R-Mutura/HDMI-TO-MIPI-MAIN/assets/PCB Design.jpg

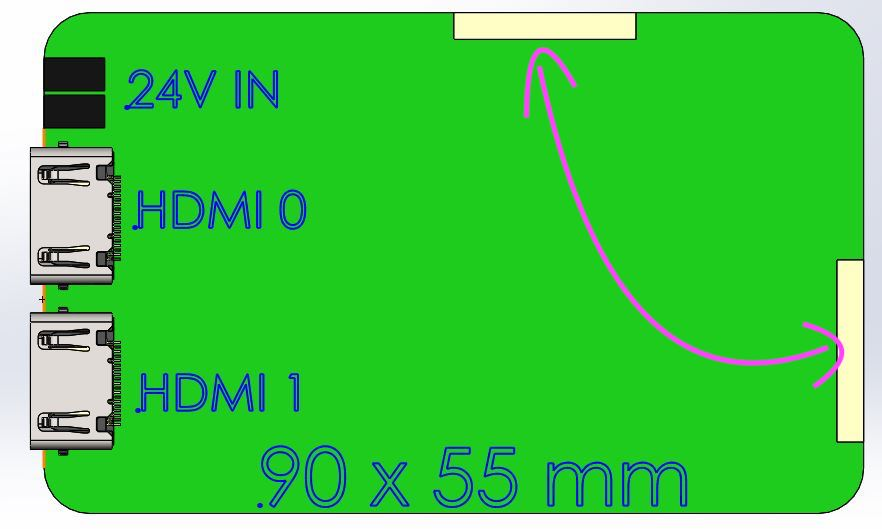
assets/PCB Design.jpg
