R-Mutura/HDMI-TO-MIPI-MAIN/assets/image (2).png

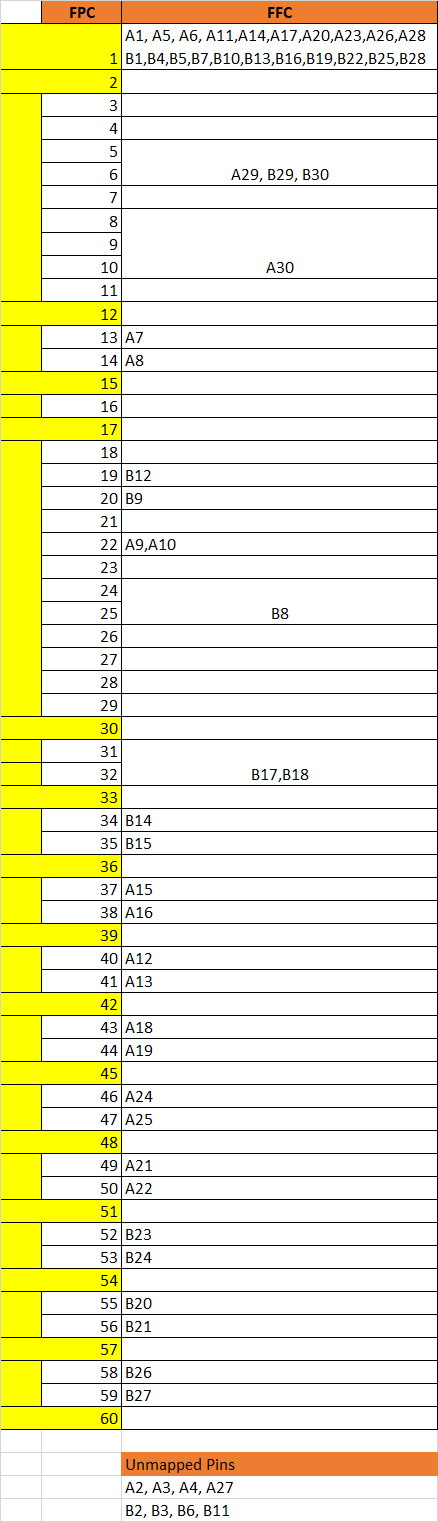
assets/image (2).png
