R-Mutura/HDMI-TO-MIPI-MAIN/assets/TC358870_1.jpeg

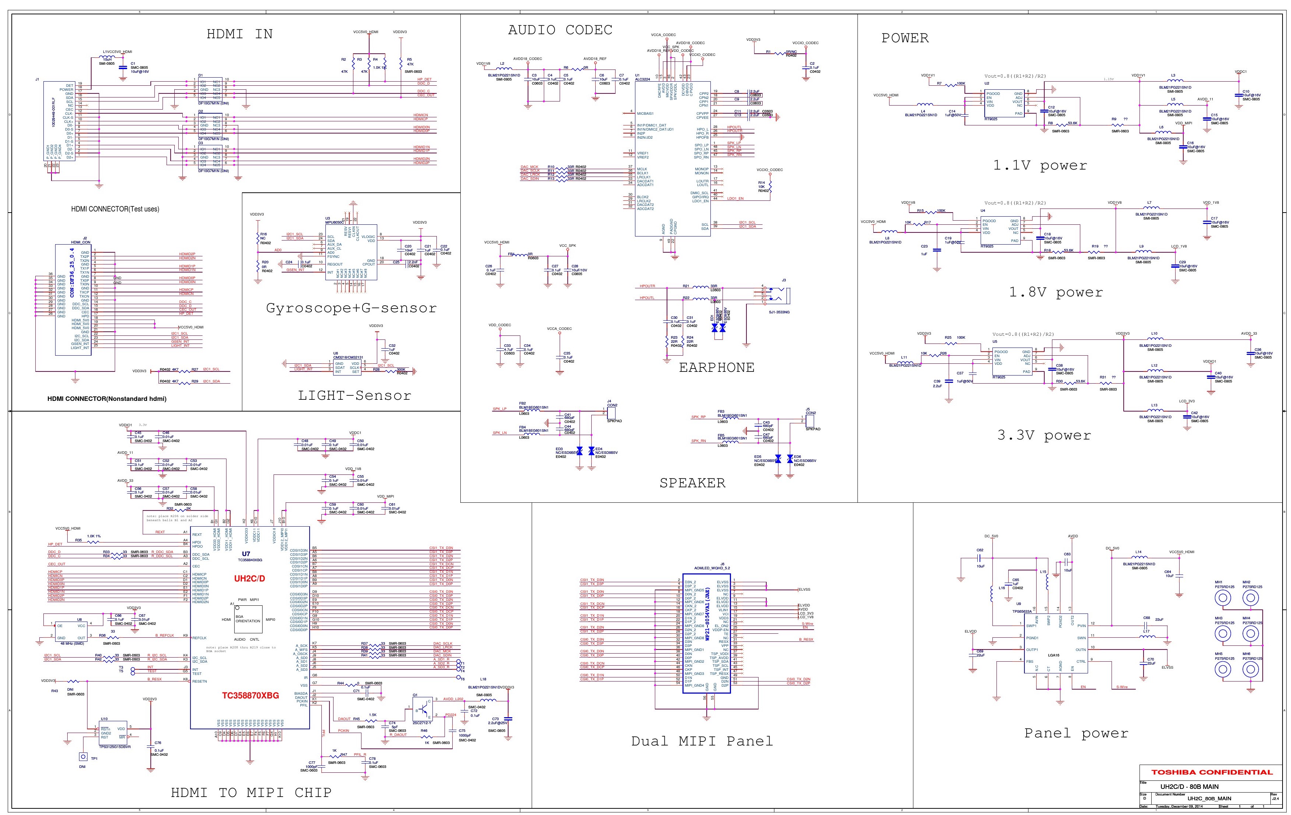
assets/TC358870_1.jpeg
