R-Mutura/HDMI-TO-MIPI-MAIN/img/hdmi_to_mipi-dsi_converter_1.png

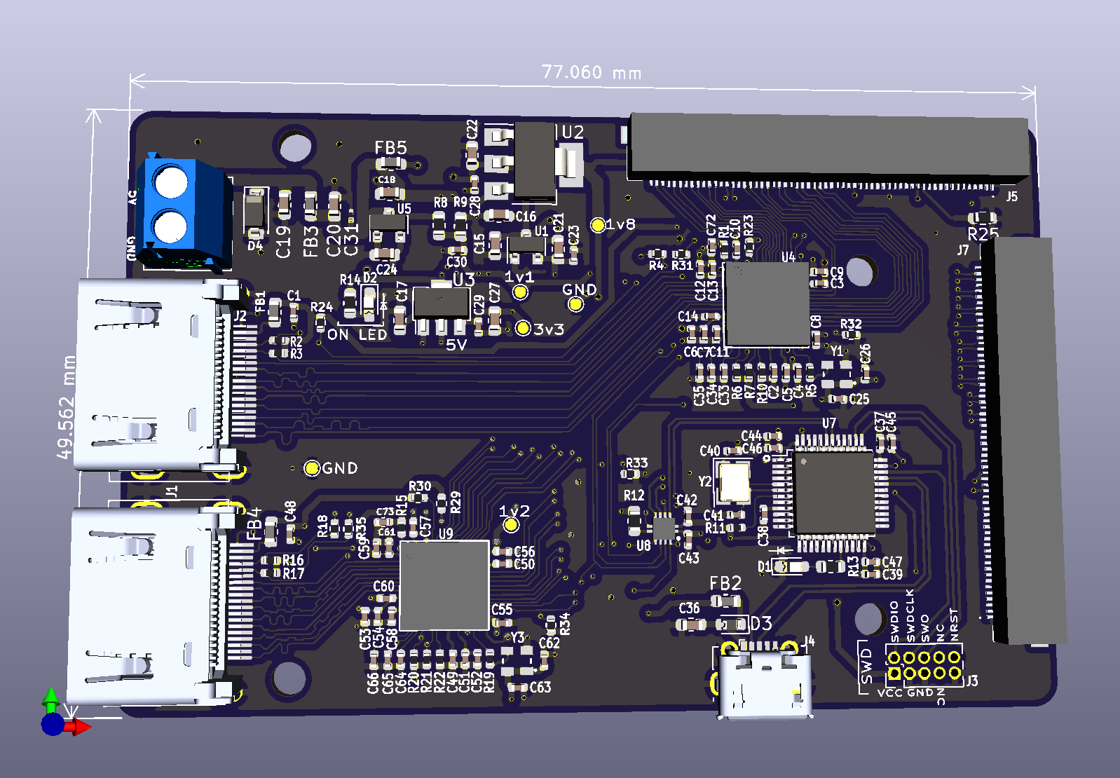
img/hdmi_to_mipi-dsi_converter_1.png
