R-Mutura/HDMI-TO-MIPI-MAIN/bom/hdmi_to_mipi-dsi_converter version 2.xlsx

REFERNCE | VALUE | FOOTPRINT | DESCRIPTION | DESCRIPTION | MFR | MPN | SUPPLIER | QUANTITY
C1, C3, C5, C7, C9, C11, C13, C14, C48, C50, C52, C54, C56, C58, C60, C61 | 10n | Capacitor_SMD:C_0402_1005Metric | 402 |  | YAGEO | CC0402KRX5R8BB103 | LCSC | 16
C16, C22 | 10uF | Capacitor_SMD:C_0603_1608Metric | 603 |  | YAGEO | CC0603KRX5R6BB106 | LCSC | 2
C17, C20 | 1uF | Capacitor_SMD:C_0603_1608Metric | 603 |  | YAGEO | CC0603KRX5R8BB105 | LCSC | 2
C2, C4, C6, C8, C10, C12, C23, C25, C29, C30, C33-C35, C37-C39, C42, C43, C49, C51, C53, C55, C57, C59, C62, C64-C66 | 0.1u | Capacitor_SMD:C_0402_1005Metric | ... |  | YAGEO | CC0402KRX7R7BB104 | LCSC | 28
C26, C63 | 0.01u | Capacitor_SMD:C_0402_1005Metric |  |  | YAGEO | CC0402KRX5R8BB103 | LCSC | 2
C27 | 1u | Capacitor_SMD:C_0603_1608Metric |  |  | YAGEO | CC0603KRX5R8BB105 | LCSC | 1
C28 | 0.1uF | Capacitor_SMD:C_0402_1005Metric |  |  | YAGEO | CC0402KRX7R7BB104 | LCSC | 1
C31 | 10pF | Capacitor_SMD:C_0603_1608Metric |  |  |  | GJM1555C1H100JB01D | DigiKey | 1
C15, C18, C19, C21, C24, C36 | 10u | Capacitor_SMD:C_0603_1608Metric |  |  | YAGEO | CC0603KRX5R6BB106 | LCSC | 6
> C40, C41 | 18p | Capacitor_SMD:C_0402_1005Metric | NPO 0402 |  | YAGEO | CC0402JRNPO9BN180 | LCSC | 2
> C44, C45 | 10u | Capacitor_SMD:C_0402_1005Metric |  |  | YAGEO | CC0402MRX5R5BB106 | LCSC | 2
> C46, C47 | 4.7u | Capacitor_SMD:C_0402_1005Metric |  |  | YAGEO | CC0402KRX5R6BB475 | LCSC | 2
> C72, C73 | 10nF | Capacitor_SMD:C_0402_1005Metric |  |  | YAGEO (https://lcsc.com/product-detail/Multilayer-Ceramic-Capacitors-MLCC-SMD-SMT_YAGEO-CC0402KRX7R9BB103_C60133.html) | CC0402KRX7R9BB103 (https://lcsc.com/product-detail/Multilayer-Ceramic-Capacitors-MLCC-SMD-SMT_YAGEO-CC0402KRX7R9BB103_C60133.html) | LCSC | 2
> D1, D2 | LED_Small | LED_SMD:LED_0603_1608Metric_Castellated |  |  | LITEON | LTST-C191KRKT (https://www.digikey.com/en/products/detail/lite-on-inc/LTST-C191KRKT/386837) | DigiKey | 2
D3 | CDBURT0530LL-HF | Diode_SMD:D_0603_1608Metric |  | 500mA | Comchip Technology | CDBURT0530LL-HF | DigiKey | 1
D4 | FSV360FP | Diode_SMD:D_SOD-123 |  |  | onsemi | FSV360FP | DigiKey | 1
> FB1, FB4 | FBMJ1608HS280NTR | Inductor_SMD:L_0603_1608Metric |  |  | Taiyo Yuden | FBMJ1608HS280NTR | DigiKey | 2
FB2 | FBMJ1608HS280NTR | Inductor_SMD:L_0603_1608Metric |  |  | Taiyo Yuden | FBMJ1608HS280NTR | DigiKey | 1
FB3, FB5 | FBMJ1608HS280NTR | Inductor_SMD:L_0603_1608Metric |  |  | Taiyo Yuden | FBMJ1608HS280NTR | DigiKey | 2
J1, J2 | HDMI-019S | HDMI:HDMI-019S |  |  | SOFNG | HDMI-019S | LCSC | 2
J3 | Conn_02x05_Odd_Even | Connector_PinHeader_1.27mm:PinHeader_2x05_P1.27mm_Vertical |  |  | Amphenol ICC (FCI) | 20021111-00010T1LF | DigiKey | 1
J4 | USB_B_Micro | Connector_USB:USB_Micro-B_Molex-105017-0001 |  |  | MOLEX | 1050170001 | LCSC | 1
> J5, J7 | XF2M60151AH | 60_PIN_FPC:XF2M60151AH |  |  | Omron Electronics | XF2M-6015-1AH | LCSC | 2
J6 | Conn_01x02 | TerminalBlock_4Ucon:TerminalBlock_4Ucon_1x02_P3.50mm_Horizontal |  |  | Cixi Kefa Elec | KF350-3.5-2P | LCSC | 1
> R1, R15 | 2k | Resistor_SMD:R_0402_1005Metric |  |  | YAGEO | RC0402JR-072KL | LCSC | 2
> R2, R3, R16, R17 | 47k | Resistor_SMD:R_0402_1005Metric |  |  | YAGEO | RC0402FR-0747KL | DigiKey | 4
> R4, R18, R31, R35 | 33 Ohm | Resistor_SMD:R_0402_1005Metric |  |  | YAGEO | RC0402JR-0733RL | LCSC | 4
> R5, R19 | 33R | Resistor_SMD:R_0402_1005Metric |  |  | YAGEO | RC0402FR-0733RL | LCSC | 2
R8 | 4k | Resistor_SMD:R_0603_1608Metric |  |  | YAGEO | AC0603FR-074K02L | LCSC | 1
R9 | 2k | Resistor_SMD:R_0603_1608Metric |  |  | YAGEO | RC0603FR-072KL | LCSC | 1
R6, R7, R10, R11, R20-R22 | 10k | Resistor_SMD:R_0402_1005Metric |  |  | YAGEO | SR0402FR-0710KL | LCSC | 7
R12 | 47k | Resistor_SMD:R_0603_1608Metric |  |  | YAGEO | RC0603FR-0747KL | LCSC | 1
R13, R14 | 1k | Resistor_SMD:R_0603_1608Metric |  |  | YAGEO | AC0603FR-071KL | LCSC | 2
R23, R24, R29, R30 | 2.2K | Resistor_SMD:R_0402_1005Metric |  |  | YAGEO | RC0402JR-072K2L | DigiKey | 4
R25 | 61.9K | Resistor_SMD:R_0603_1608Metric |  |  | Stackpole Electronics Inc | RMCF0603FT61K9 | DigiKey | 1
R32, R34 | 10K | Resistor_SMD:R_0402_1005Metric |  |  | YAGEO | SR0402FR-0710KL | DigiKey | 2
R33 | 47K | Resistor_SMD:R_0402_1005Metric |  |  | YAGEO | RC0402FR-0747KL | DigiKey | 1
U1 | MCP1700-1202E_SOT23 | Package_TO_SOT_SMD:SOT-23 |  |  | Microchip Tech | MCP1700-1202E_SOT23 | LCSC | 1
U2 | AX1007E18A | Package_TO_SOT_SMD:SOT-223-3_TabPin2 | 1A |  | Axelite Tech | AX1007E18A | LCSC | 1
U3 | ME6211A33PG-N | Package_TO_SOT_SMD:SOT-89-3 | 500mA |  | MICRON | ME6211A33PG-N | LCSC | 1
U4, U9 | TC358870XBG_NOK_ | TC358870XBG:VFBGA-80_7x7mm_Pitch0.65mm |  |  | Toshiba | TC358870XBG(NOK) | MOUSER | 2
U5 | MCP1700-3302E_SOT23 | Package_TO_SOT_SMD:SOT-23 |  |  | Microchip Tech | MCP1700T-3302E/TT | LCSC | 1
U7 | STM32F103C8Tx | Package_QFP:LQFP-48_7x7mm_P0.5mm |  |  | STMicroelectronics | STM32F103C8Tx | LCSC | 1
U8 | FXMA2104UMX | Barrel - Audio Connectors:QFN40P180X180X55-12N |  |  | ON Semiconductor | FXMA2104UMX | LCSC | 1
Y1, Y3 | CRYSTAL_48MHZ | Barrel - Audio Connectors:DSC6101JI2A-048.0000 |  |  | Microchip Technology | DSC6101JI2A-048.0000 | DIGIKEY | 2
Y2 | 8MHz | Crystal:Crystal_SMD_3225-4Pin_3.2x2.5mm |  |  | XTY | 7325-0800A2010-00 | LCSC | 1
