R-Mutura/HDMI-TO-MIPI-MAIN/sch_pdf/schematic.pdf

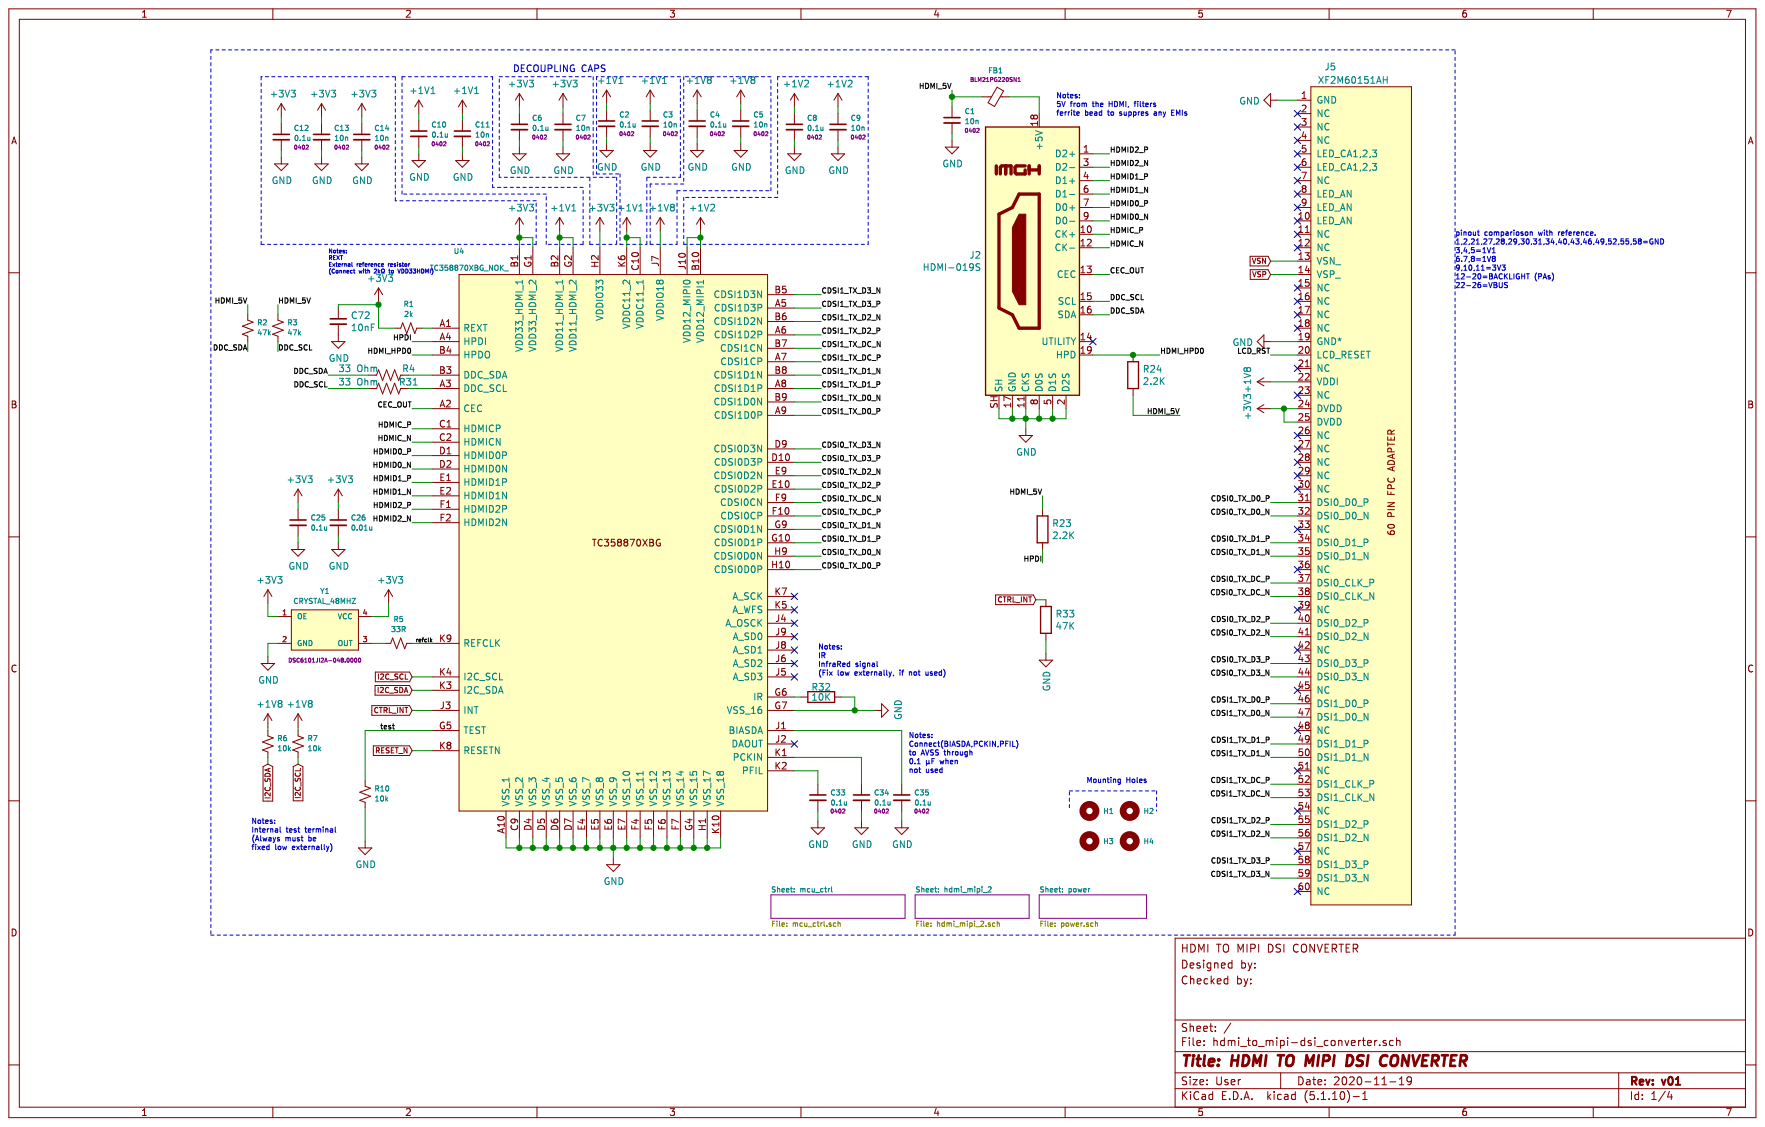
[picture p10: page 1]

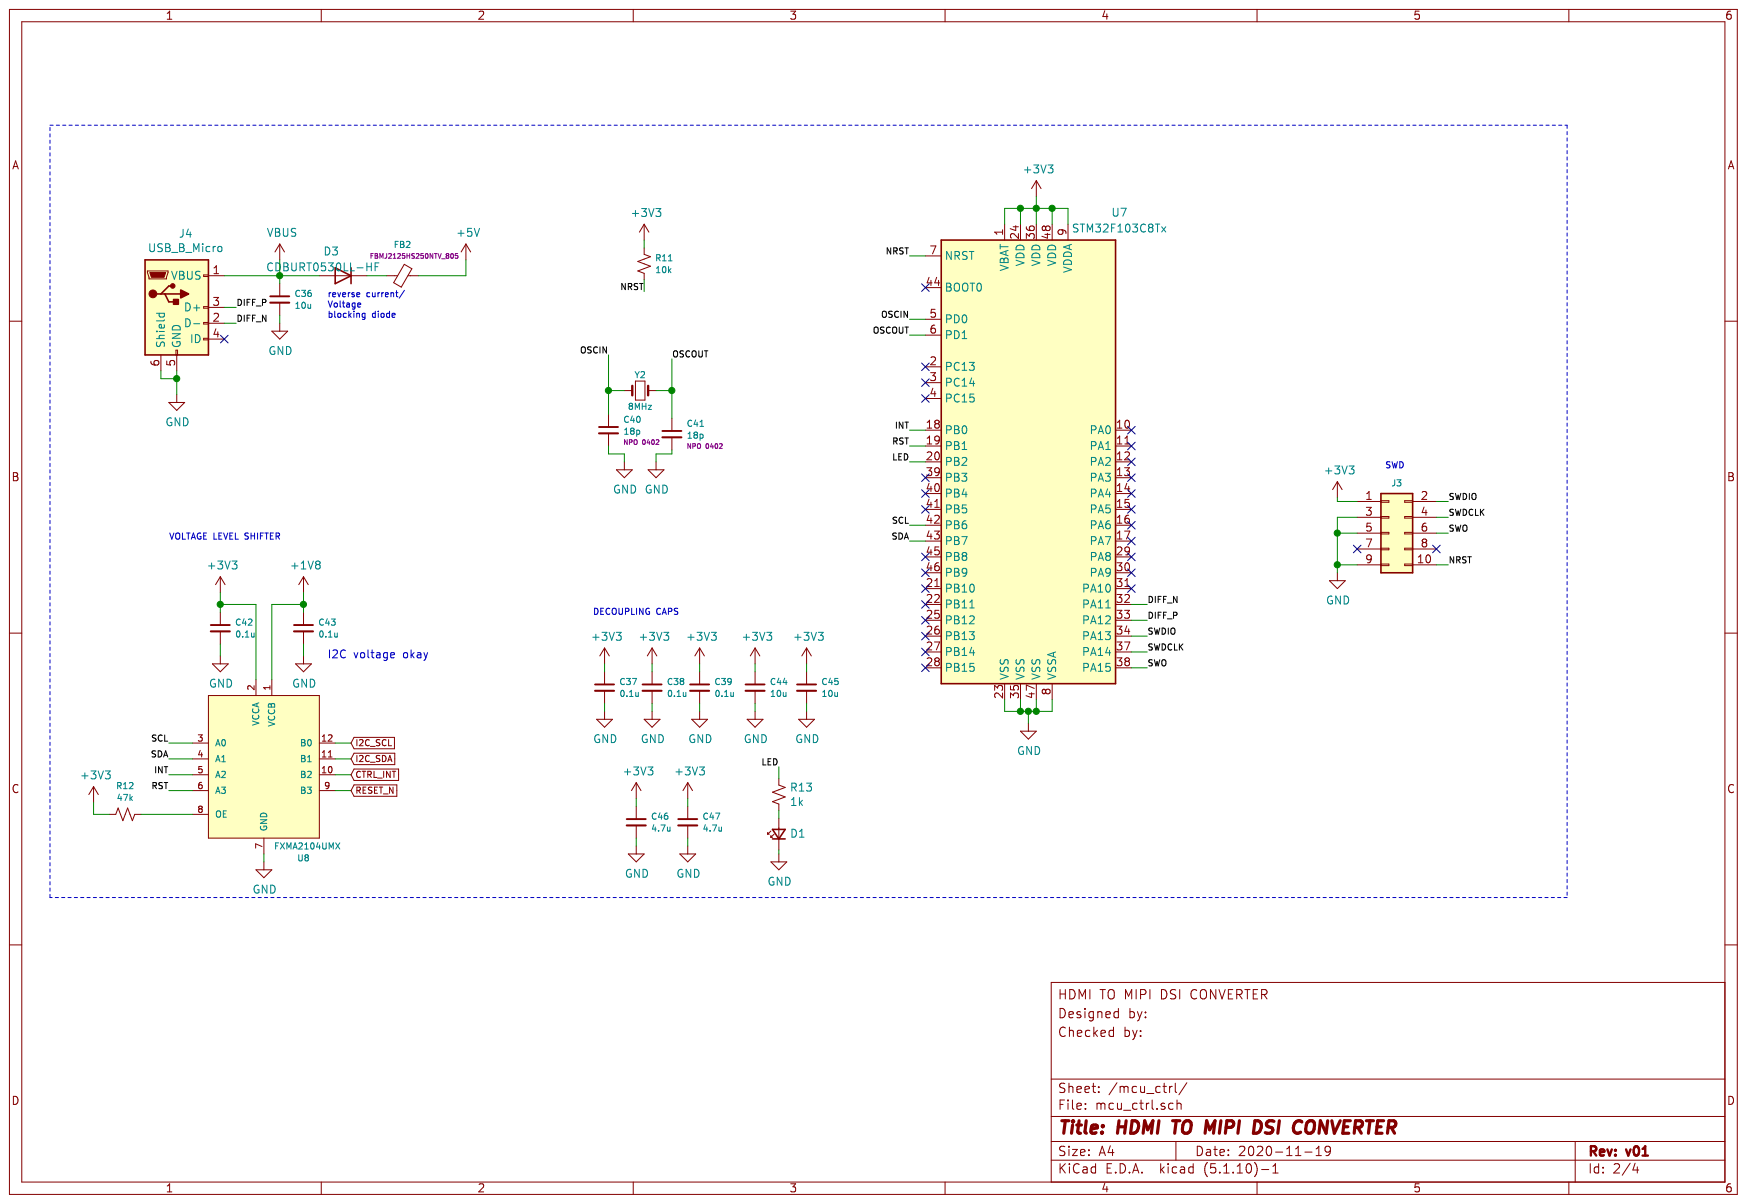
[picture p11: page 2]

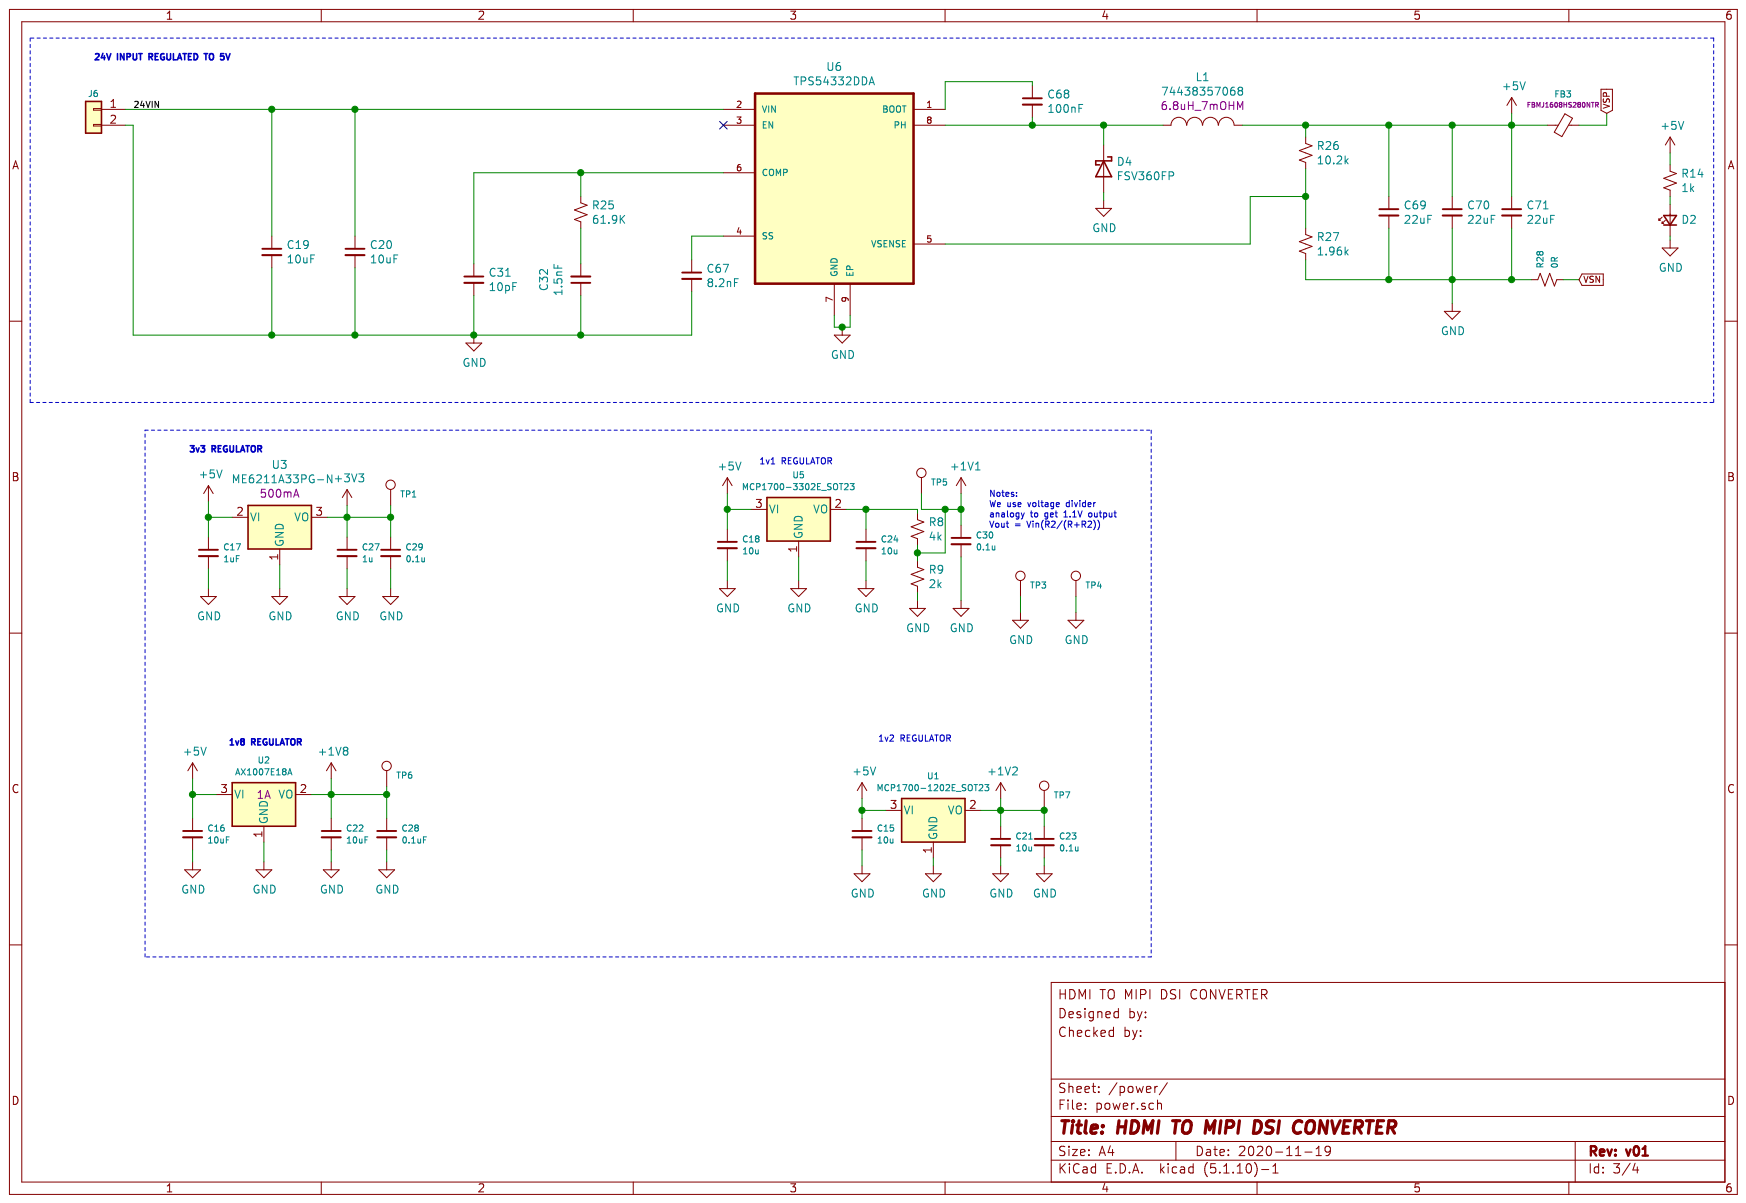
[picture p12: page 3]

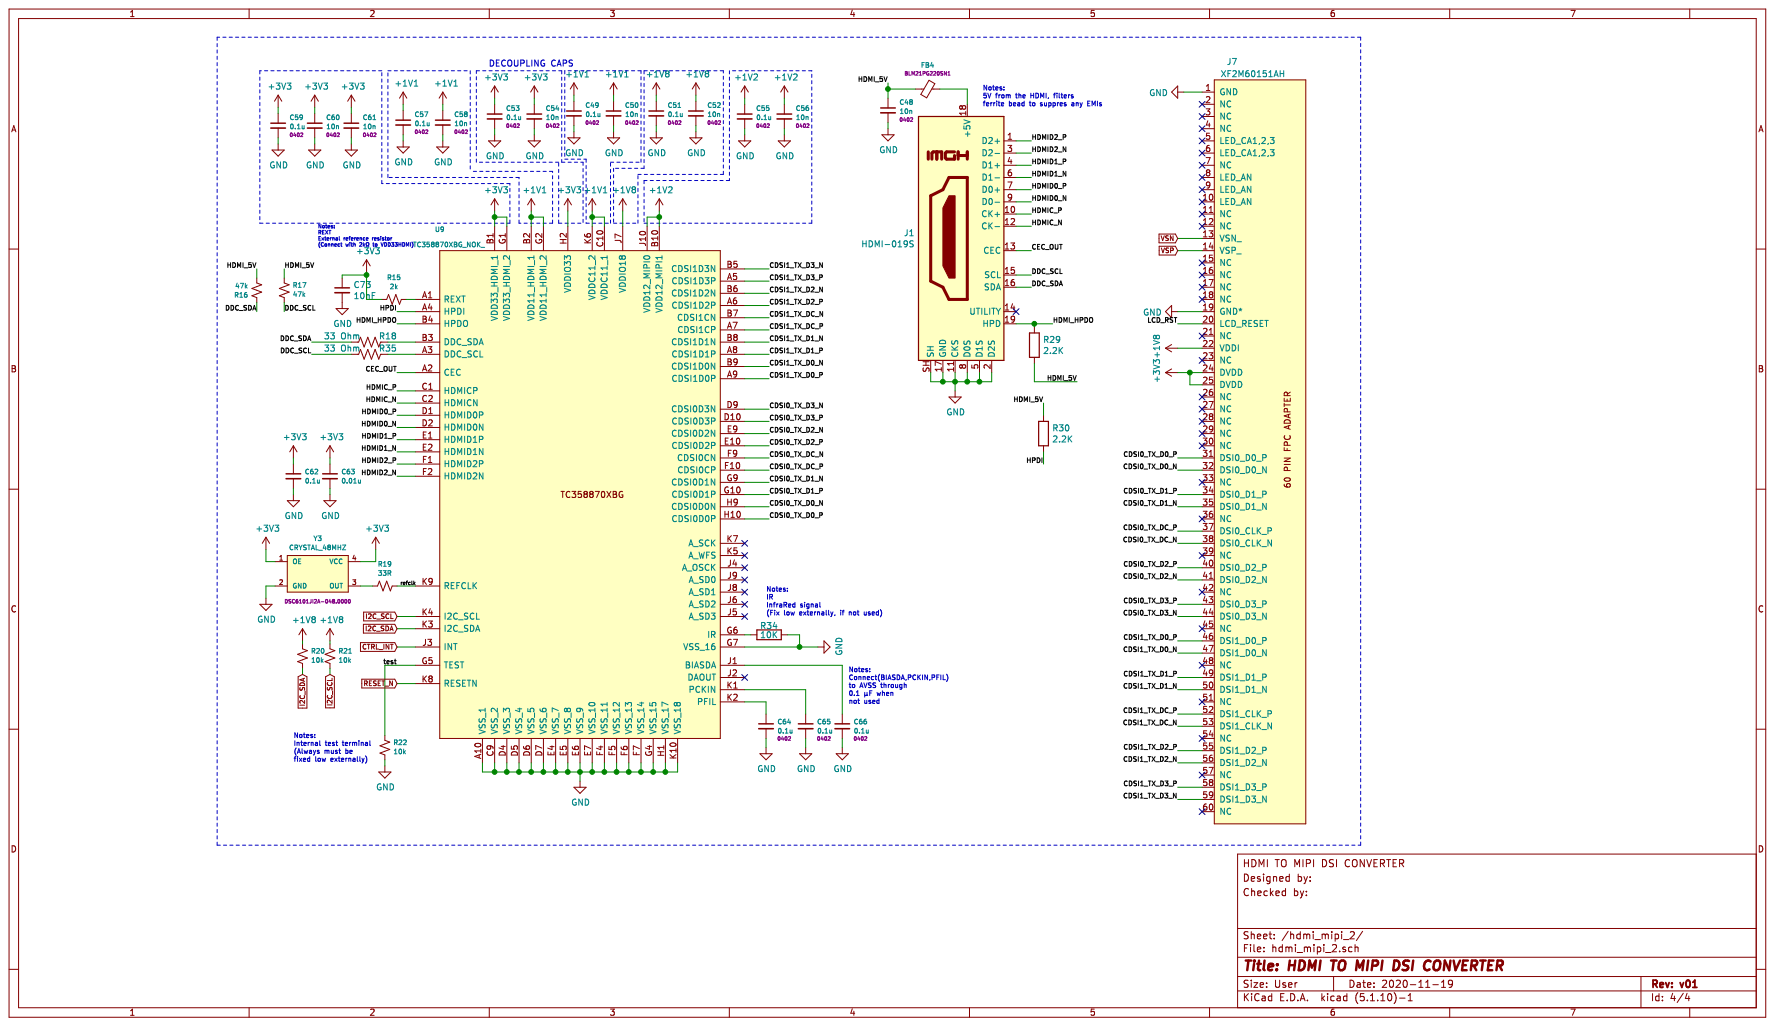
[picture p13: page 4]
