R-Mutura/HDMI-TO-MIPI-MAIN/src_files/hdmi_to_mipi-dsi_converter.kicad_pcb

## KiCad design src_files/hdmi_to_mipi-dsi_converter.kicad_pcb (2021-12-23)

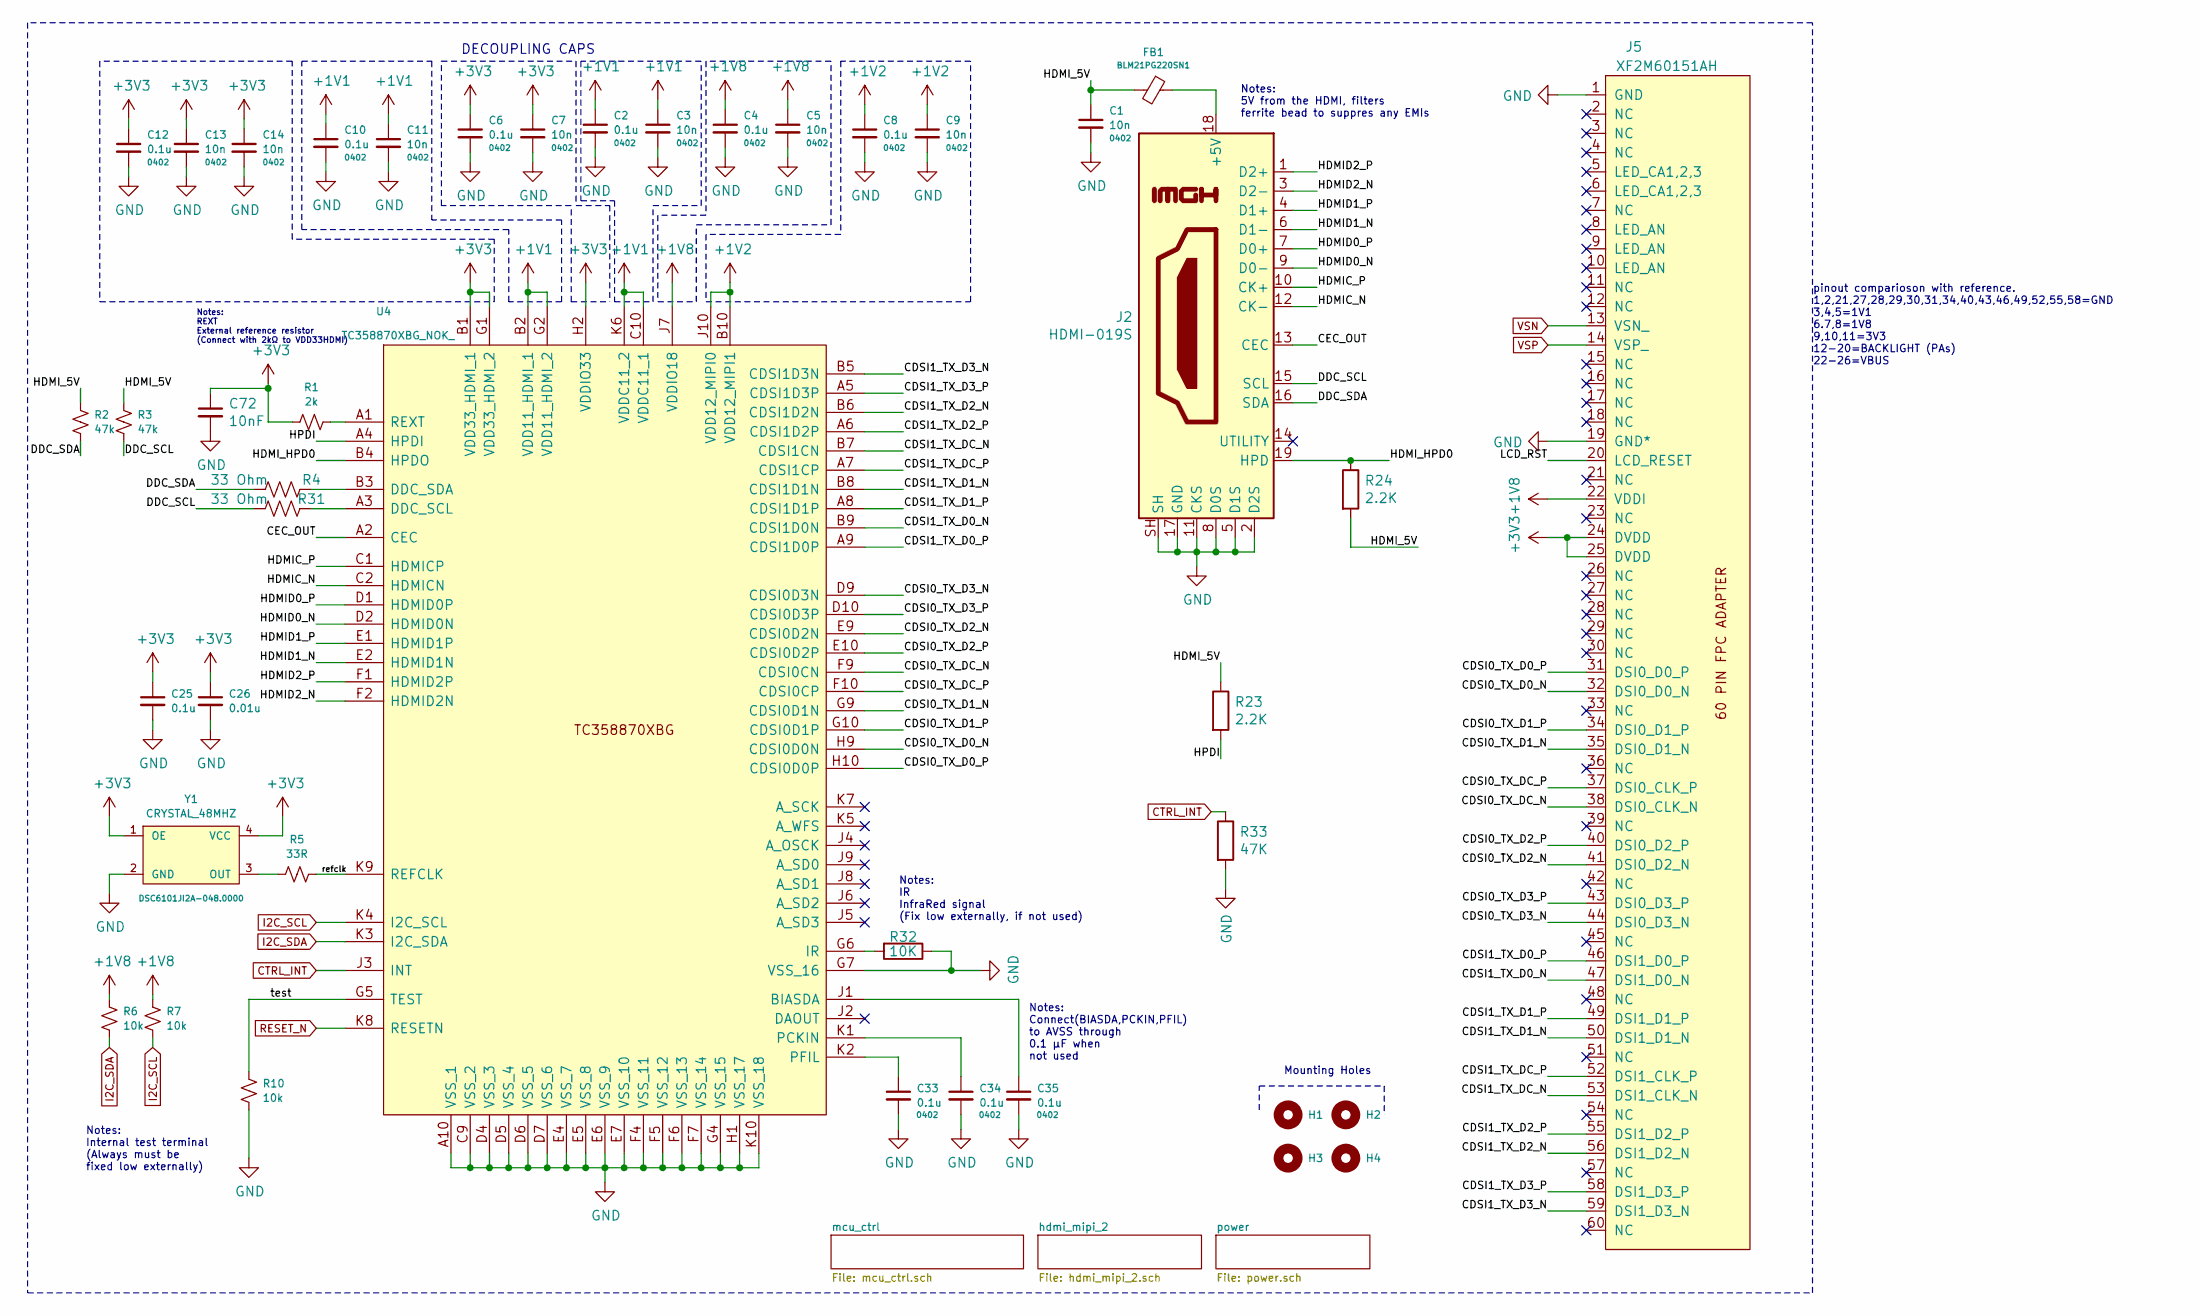
[picture p14: schematic hdmi_to_mipi-dsi_converter.sch, HDMI TO MIPI DSI CONVERTER]

Parts:
C1, C3, C5, C7, C9, C11, C13, C14: 10n; C_0402_1005Metric
C2, C4, C6, C8, C10, C12, C25, C33, C34, C35: 0.1u; C_0402_1005Metric
C26: 0.01u; C_0402_1005Metric
C72: 10nF; C_0402_1005Metric
FB1: Ferrite_Bead_Small; L_0603_1608Metric; MPN BLM21PG220SN1
H1, H2, H3, H4: MountingHole; MountingHole_2.7mm_M2.5
J2: HDMI-019S; MPN HDMI-019S
J5: XF2M60151AH
R1: 2k; R_0402_1005Metric
R2, R3: 47k; R_0402_1005Metric
R4, R31: 33 Ohm; R_0402_1005Metric
R5: 33R; R_0402_1005Metric
R6, R7, R10: 10k; R_0402_1005Metric
R23, R24: 2.2K; R_0402_1005Metric
R32: 10K; R_0402_1005Metric
R33: 47K; R_0402_1005Metric
U4: TC358870XBG_NOK_; VFBGA-80_7x7mm_Pitch0.65mm; MPN TC358870XBG(NOK)
Y1: CRYSTAL_48MHZ; DSC6101JI2A-048.0000; MPN DSC6101JI2A-048.0000

Connections:
+1V1: C2.1, C3.1, C10.1, C11.1, U4.B2 (VDD11_HDMI_1), U4.C10 (VDDC11_1), U4.G2 (VDD11_HDMI_2), U4.K6 (VDDC11_2); also elsewhere on the board
+1V2: C8.1, C9.1, U4.B10 (VDD12_MIPI1), U4.J10 (VDD12_MIPI0); also elsewhere on the board
+1V8: C4.1, C5.1, J5.22 (VDDI), R6.2, R7.2, U4.J7 (VDDIO18); also elsewhere on the board
+3V3: C6.1, C7.1, C12.1, C13.1, C14.1, C25.1, C26.1, C72.1, J5.24 (DVDD), J5.25 (DVDD), R1.2, U4.B1 (VDD33_HDMI_1), U4.G1 (VDD33_HDMI_2), U4.H2 (VDDIO33), Y1.1 (OE), Y1.4 (VCC); also elsewhere on the board
/CDSI0_TX_D0_N: J5.32 (DSI0_D0_N), U4.H9 (CDSI0D0N)
/CDSI0_TX_D0_P: J5.31 (DSI0_D0_P), U4.H10 (CDSI0D0P)
/CDSI0_TX_D1_N: J5.35 (DSI0_D1_N), U4.G9 (CDSI0D1N)
/CDSI0_TX_D1_P: J5.34 (DSI0_D1_P), U4.G10 (CDSI0D1P)
/CDSI0_TX_D2_N: J5.41 (DSI0_D2_N), U4.E9 (CDSI0D2N)
/CDSI0_TX_D2_P: J5.40 (DSI0_D2_P), U4.E10 (CDSI0D2P)
/CDSI0_TX_D3_N: J5.44 (DSI0_D3_N), U4.D9 (CDSI0D3N)
/CDSI0_TX_D3_P: J5.43 (DSI0_D3_P), U4.D10 (CDSI0D3P)
/CDSI0_TX_DC_N: J5.38 (DSI0_CLK_N), U4.F9 (CDSI0CN)
/CDSI0_TX_DC_P: J5.37 (DSI0_CLK_P), U4.F10 (CDSI0CP)
/CDSI1_TX_D0_N: J5.47 (DSI1_D0_N), U4.B9 (CDSI1D0N)
/CDSI1_TX_D0_P: J5.46 (DSI1_D0_P), U4.A9 (CDSI1D0P)
/CDSI1_TX_D1_N: J5.50 (DSI1_D1_N), U4.B8 (CDSI1D1N)
/CDSI1_TX_D1_P: J5.49 (DSI1_D1_P), U4.A8 (CDSI1D1P)
/CDSI1_TX_D2_N: J5.56 (DSI1_D2_N), U4.B6 (CDSI1D2N)
/CDSI1_TX_D2_P: J5.55 (DSI1_D2_P), U4.A6 (CDSI1D2P)
/CDSI1_TX_D3_N: J5.59 (DSI1_D3_N), U4.B5 (CDSI1D3N)
/CDSI1_TX_D3_P: J5.58 (DSI1_D3_P), U4.A5 (CDSI1D3P)
/CDSI1_TX_DC_N: J5.53 (DSI1_CLK_N), U4.B7 (CDSI1CN)
/CDSI1_TX_DC_P: J5.52 (DSI1_CLK_P), U4.A7 (CDSI1CP)
/CEC_OUT: J2.13 (CEC), U4.A2 (CEC)
/DDC_SCL: J2.15 (SCL), R3.1, R31.2
/DDC_SDA: J2.16 (SDA), R2.1, R4.2
/HDMIC_N: J2.12 (CK-), U4.C2 (HDMICN)
/HDMIC_P: J2.10 (CK+), U4.C1 (HDMICP)
/HDMID0_N: J2.9 (D0-), U4.D2 (HDMID0N)
/HDMID0_P: J2.7 (D0+), U4.D1 (HDMID0P)
/HDMID1_N: J2.6 (D1-), U4.E2 (HDMID1N)
/HDMID1_P: J2.4 (D1+), U4.E1 (HDMID1P)
/HDMID2_N: J2.3 (D2-), U4.F2 (HDMID2N)
/HDMID2_P: J2.1 (D2+), U4.F1 (HDMID2P)
/HDMI_5V: C1.1, FB1.2, R2.2, R3.2, R23.1, R24.2
/HDMI_HPD0: J2.19 (HPD), R24.1, U4.B4 (HPDO)
/HPDI: R23.2, U4.A4 (HPDI)
/refclk: R5.1, U4.K9 (REFCLK)
/test: R10.2, U4.G5 (TEST)
CTRL_INT: R33.1, U4.J3 (INT); also elsewhere on the board
GND: C1.2, C2.2, C3.2, C4.2, C5.2, C6.2, C7.2, C8.2, C9.2, C10.2, C11.2, C12.2, C13.2, C14.2, C25.2, C26.2, C33.2, C34.2, C35.2, C72.2, J2.2 (D2S), J2.5 (D1S), J2.8 (D0S), J2.11 (CKS), J2.17 (GND), J2.SH, J5.1 (GND), J5.19 (GND*), R10.1, R32.1, R33.2, U4.A10 (VSS_1), U4.C9 (VSS_2), U4.D4 (VSS_3), U4.D5 (VSS_4), U4.D6 (VSS_5), U4.D7 (VSS_6), U4.E4 (VSS_7), U4.E5 (VSS_8), U4.E6 (VSS_9), U4.E7 (VSS_10), U4.F4 (VSS_11), U4.F5 (VSS_12), U4.F6 (VSS_13), U4.F7 (VSS_14), U4.G4 (VSS_15), U4.G7 (VSS_16), U4.H1 (VSS_17), U4.K10 (VSS_18), Y1.2 (GND); also elsewhere on the board
I2C_SCL: R7.1, U4.K4 (I2C_SCL); also elsewhere on the board
I2C_SDA: R6.1, U4.K3 (I2C_SDA); also elsewhere on the board
unnamed: C33.1, U4.K2 (PFIL)
unnamed: C34.1, U4.K1 (PCKIN)
unnamed: C35.1, U4.J1 (BIASDA)
unnamed: FB1.1, J2.18 (+5V)
unnamed: R1.1, U4.A1 (REXT)
unnamed: R4.1, U4.B3 (DDC_SDA)
unnamed: R5.2, Y1.3 (OUT)
unnamed: R31.1, U4.A3 (DDC_SCL)
unnamed: R32.2, U4.G6 (IR)
RESET_N: U4.K8 (RESETN); also elsewhere on the board
VSN: J5.13 (VSN_); also elsewhere on the board
VSP: J5.14 (VSP_); also elsewhere on the board

Notes on the sheet:
DECOUPLING CAPS
Notes: Internal test terminal (Always must be fixed low externally)
Notes: IR InfraRed signal (Fix low externally, if not used)
Notes: Connect(BIASDA,PCKIN,PFIL) to AVSS through 0.1 μF when not used
Notes: REXT External reference resistor (Connect with 2kΩ to VDD33HDMI)
Notes: 5V from the HDMI, filters ferrite bead to suppres any EMIs
Mounting Holes
pinout comparioson with reference. 1,2,21,27,28,29,30,31,34,40,43,46,49,52,55,58=GND 3,4,5=1V1 6.7,8=1V8 9,10,11=3V3 12-20=BACKLIGHT (PAs) 22-26=VBUS

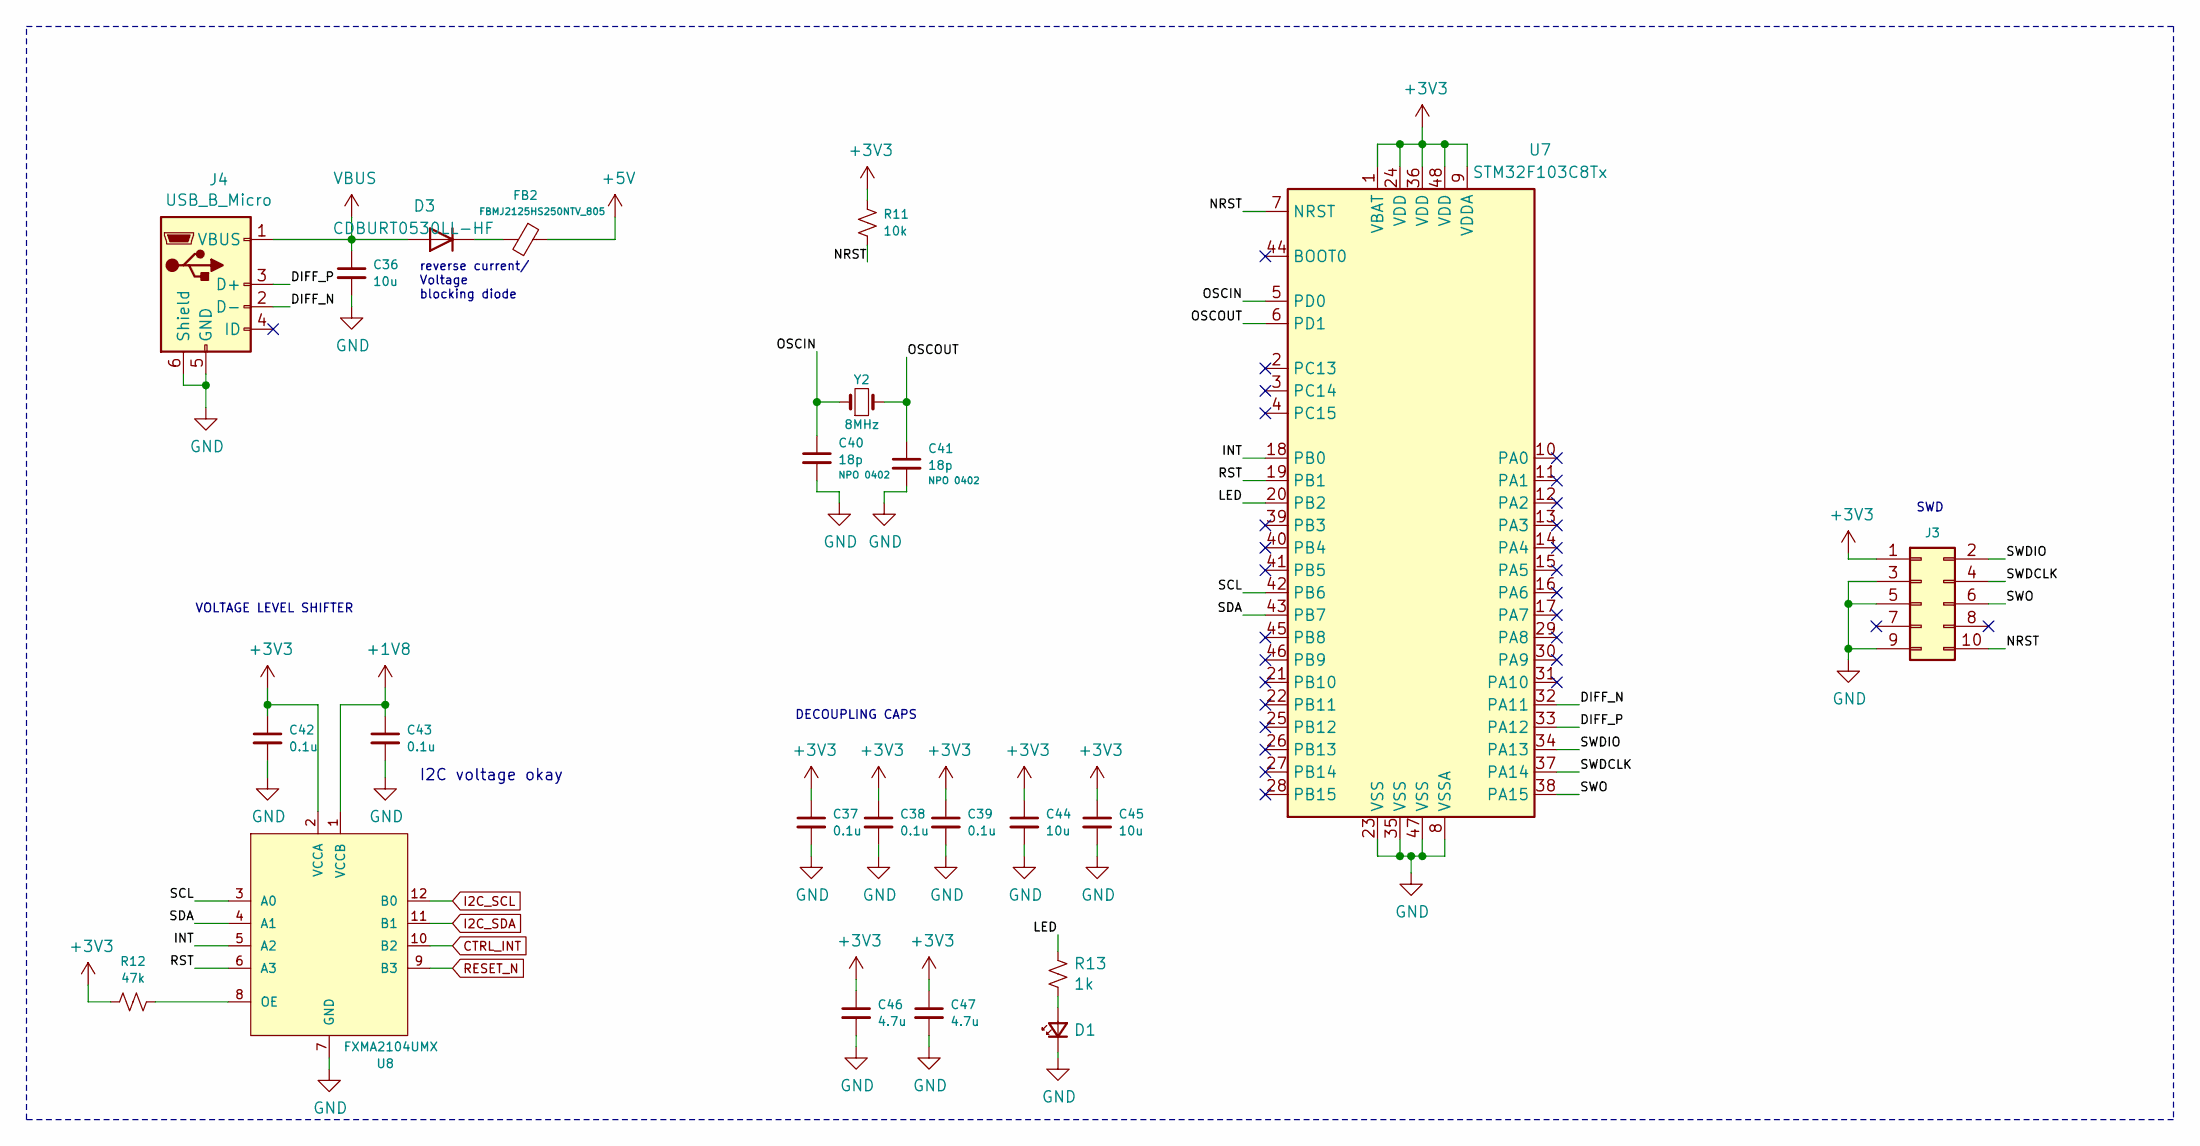
[picture p15: schematic mcu_ctrl.sch, HDMI TO MIPI DSI CONVERTER]

Parts:
C36: 10u; C_0603_1608Metric
C37, C38, C39, C42, C43: 0.1u; C_0402_1005Metric
C40, C41: 18p; C_0402_1005Metric
C44, C45: 10u; C_0402_1005Metric
C46, C47: 4.7u; C_0402_1005Metric
D1: LED_Small; LED_0603_1608Metric_Castellated
D3: CDBURT0530LL-HF; D_0603_1608Metric; MPN CDBURT0530LL-HF
FB2: BLM21PG220SN1; L_0603_1608Metric; MPN FBMJ2125HS250NTV_805
J3: Conn_02x05_Odd_Even; PinHeader_2x05_P1.27mm_Vertical
J4: USB_B_Micro; USB_Micro-B_Molex-105017-0001
R11: 10k; R_0402_1005Metric
R12: 47k; R_0603_1608Metric
R13: 1k; R_0603_1608Metric
U7: STM32F103C8Tx; LQFP-48_7x7mm_P0.5mm
U8: FXMA2104UMX; QFN40P180X180X55-12N
Y2: 8MHz; Crystal_SMD_3225-4Pin_3.2x2.5mm

Connections:
+1V8: C43.1, U8.1 (VCCB); also elsewhere on the board
+3V3: C37.1, C38.1, C39.1, C42.1, C44.1, C45.1, C46.1, C47.1, J3.1, R11.1, R12.2, U7.1 (VBAT), U7.9 (VDDA), U7.24 (VDD), U7.36 (VDD), U7.48 (VDD), U8.2 (VCCA); also elsewhere on the board
+5V: FB2.1; also elsewhere on the board
/mcu_ctrl/DIFF_N: J4.2 (D-), U7.32 (PA11)
/mcu_ctrl/DIFF_P: J4.3 (D+), U7.33 (PA12)
/mcu_ctrl/INT: U7.18 (PB0), U8.5 (A2)
/mcu_ctrl/LED: R13.1, U7.20 (PB2)
/mcu_ctrl/NRST: J3.10, R11.2, U7.7 (NRST)
/mcu_ctrl/OSCIN: C40.1, U7.5 (PD0), Y2.1
/mcu_ctrl/OSCOUT: C41.1, U7.6 (PD1), Y2.3
/mcu_ctrl/RST: U7.19 (PB1), U8.6 (A3)
/mcu_ctrl/SCL: U7.42 (PB6), U8.3 (A0)
/mcu_ctrl/SDA: U7.43 (PB7), U8.4 (A1)
/mcu_ctrl/SWDCLK: J3.4, U7.37 (PA14)
/mcu_ctrl/SWDIO: J3.2, U7.34 (PA13)
/mcu_ctrl/SWO: J3.6, U7.38 (PA15)
CTRL_INT: U8.10 (B2); also elsewhere on the board
GND: C36.2, C37.2, C38.2, C39.2, C40.2, C41.2, C42.2, C43.2, C44.2, C45.2, C46.2, C47.2, D1.1 (K), J3.3, J3.5, J3.9, J4.5 (GND), J4.6 (Shield), U7.8 (VSSA), U7.23 (VSS), U7.35 (VSS), U7.47 (VSS), U8.7 (GND); also elsewhere on the board
I2C_SCL: U8.12 (B0); also elsewhere on the board
I2C_SDA: U8.11 (B1); also elsewhere on the board
unnamed: D1.2 (A), R13.2
unnamed: D3.1 (K), FB2.2
unnamed: R12.1, U8.8 (OE)
RESET_N: U8.9 (B3); also elsewhere on the board
VBUS: C36.1, D3.2 (A), J4.1 (VBUS)

Notes on the sheet:
VOLTAGE LEVEL SHIFTER
SWD
DECOUPLING CAPS
I2C voltage okay
reverse current/ Voltage blocking diode

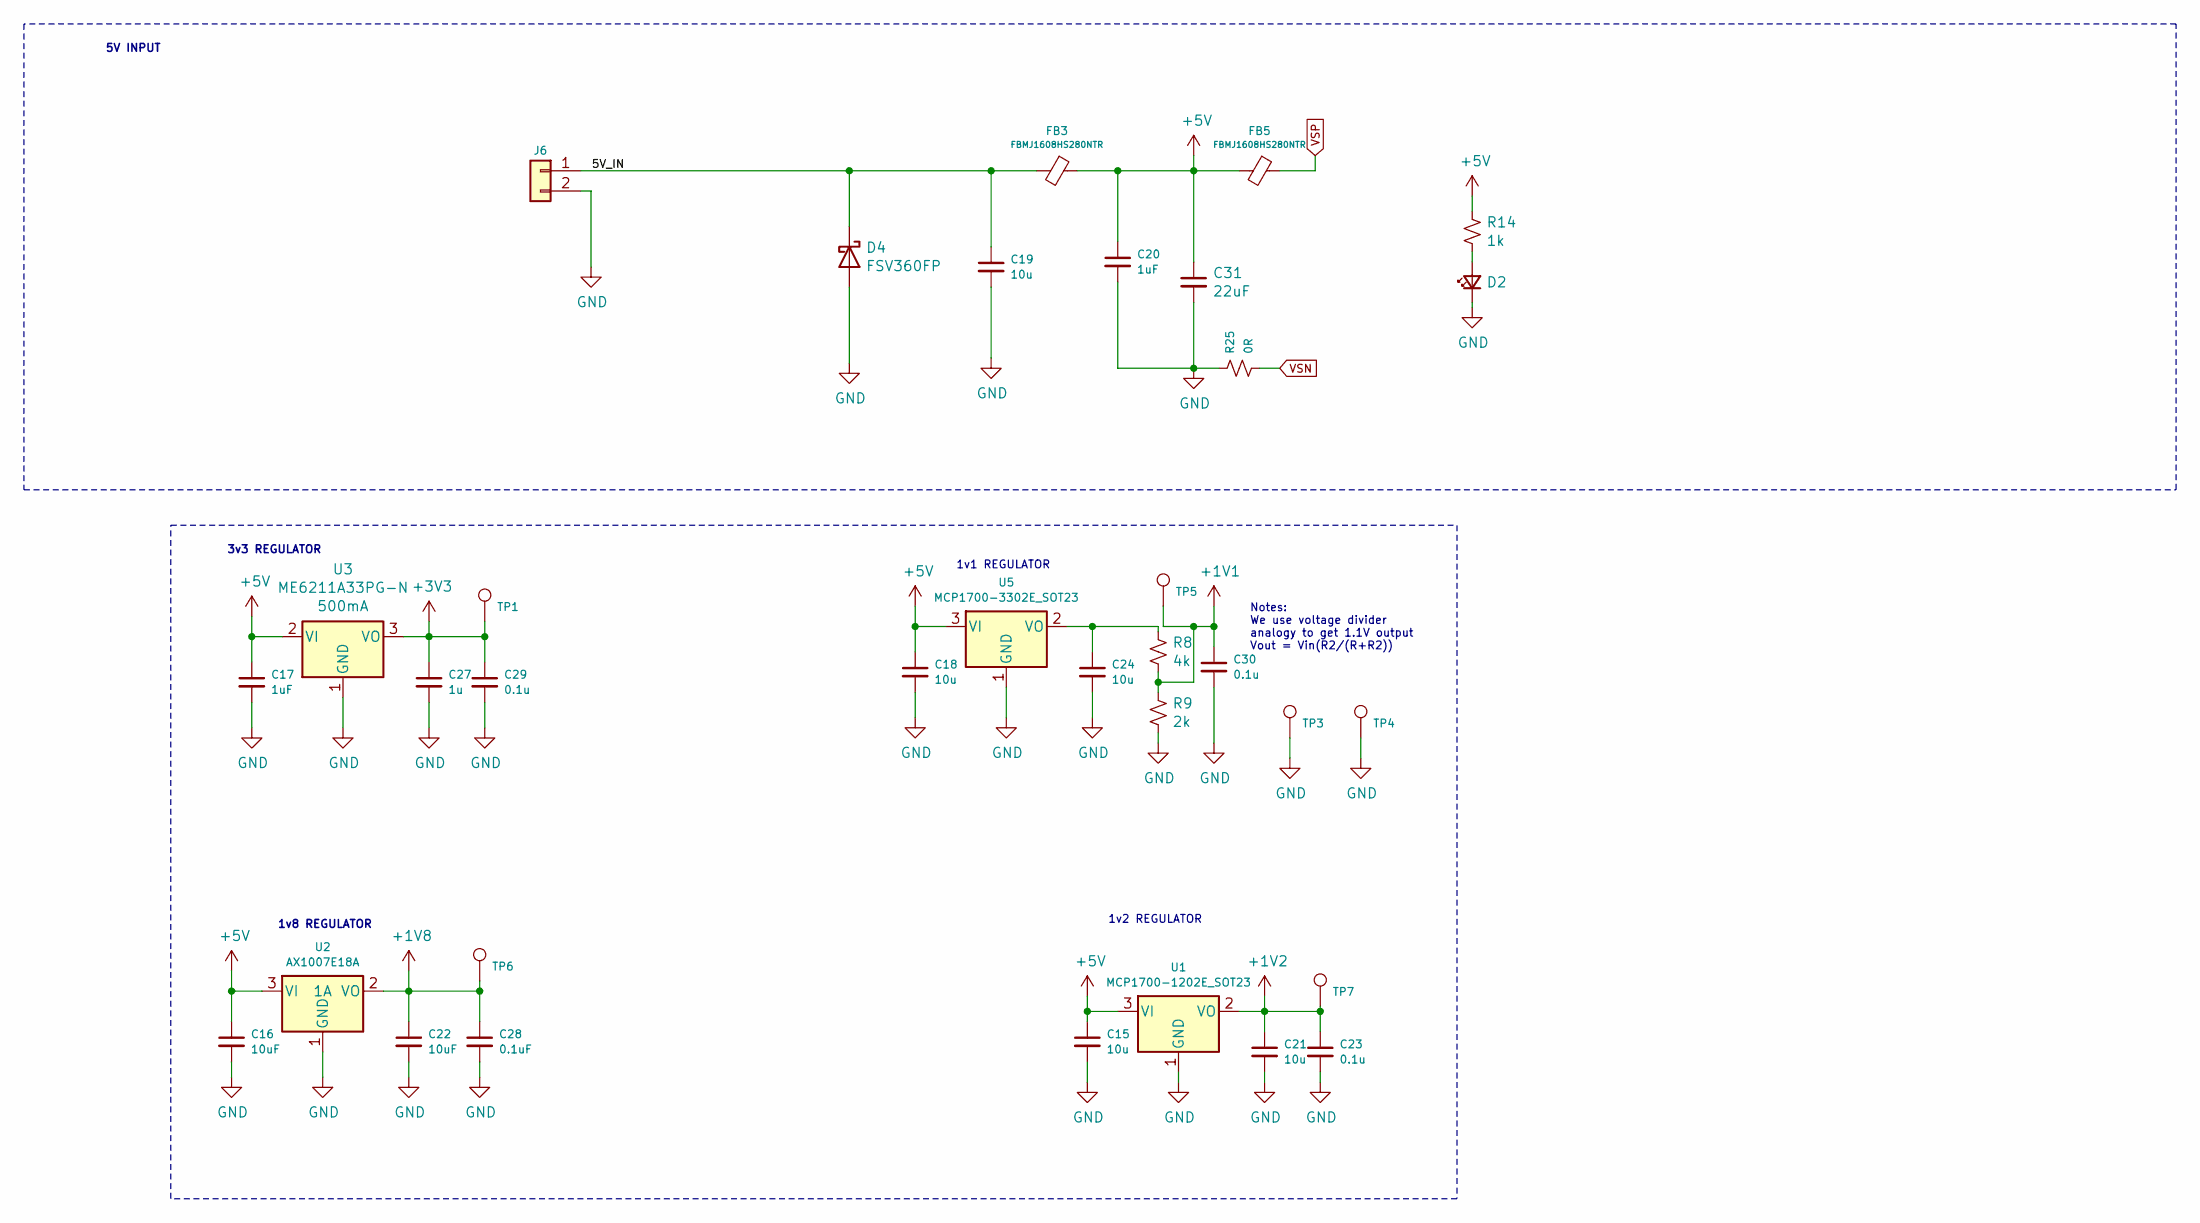
[picture p16: schematic power.sch, HDMI TO MIPI DSI CONVERTER]

Parts:
C15, C18, C19, C21, C24: 10u; C_0603_1608Metric
C16, C22: 10uF; C_0603_1608Metric
C17, C20: 1uF; C_0603_1608Metric
C23, C29, C30: 0.1u; C_0402_1005Metric
C27: 1u; C_0603_1608Metric
C28: 0.1uF; C_0402_1005Metric
C31: 22uF; R_0201_0603Metric; MPN GRM188R60J226MEA0D
D2: LED_Small; LED_0603_1608Metric_Castellated
D4: FSV360FP; D_SOD-123
FB3, FB5: FBMJ1608HS280NTR; L_0603_1608Metric; MPN FBMJ1608HS280NTR
J6: Conn_01x02; TerminalBlock_4Ucon_1x02_P3.50mm_Horizontal
R8: 4k; R_0603_1608Metric
R9: 2k; R_0603_1608Metric
R14: 1k; R_0603_1608Metric
R25: 0R; R_0603_1608Metric
TP1, TP3, TP4, TP5, TP6, TP7: TestPoint; TestPoint_Pad_D0.9mm
U1: MCP1700-1202E_SOT23; SOT-23
U2: AX1007E18A; SOT-223-3_TabPin2; MPN AX1007E18A
U3: ME6211A33PG-N; SOT-89-3; MPN ME6211A33PG-N
U5: MCP1700-3302E_SOT23; SOT-23

Connections:
+1V1: C30.1, R8.2, R9.1, TP5.1; also elsewhere on the board
+1V2: C21.1, C23.1, TP7.1, U1.2 (VO); also elsewhere on the board
+1V8: C22.1, C28.1, TP6.1, U2.2 (VO); also elsewhere on the board
+3V3: C27.1, C29.1, TP1.1, U3.3 (VO); also elsewhere on the board
+5V: C15.1, C16.1, C17.1, C18.1, C20.1, C31.1, FB3.1, FB5.2, R14.1, U1.3 (VI), U2.3 (VI), U3.2 (VI), U5.3 (VI); also elsewhere on the board
/power/5V_IN: C19.1, D4.1 (K), FB3.2, J6.1
GND: C15.2, C16.2, C17.2, C18.2, C19.2, C20.2, C21.2, C22.2, C23.2, C24.2, C27.2, C28.2, C29.2, C30.2, C31.2, D2.1 (K), D4.2 (A), J6.2, R9.2, R25.1, TP3.1, TP4.1, U1.1 (GND), U2.1 (GND), U3.1 (GND), U5.1 (GND); also elsewhere on the board
unnamed: C24.1, R8.1, U5.2 (VO)
unnamed: D2.2 (A), R14.2
VSN: R25.2; also elsewhere on the board
VSP: FB5.1; also elsewhere on the board

Notes on the sheet:
1v2 REGULATOR
1v8 REGULATOR
3v3 REGULATOR
1v1 REGULATOR
5V INPUT
Notes: We use voltage divider analogy to get 1.1V output Vout = Vin(R2/(R+R2))

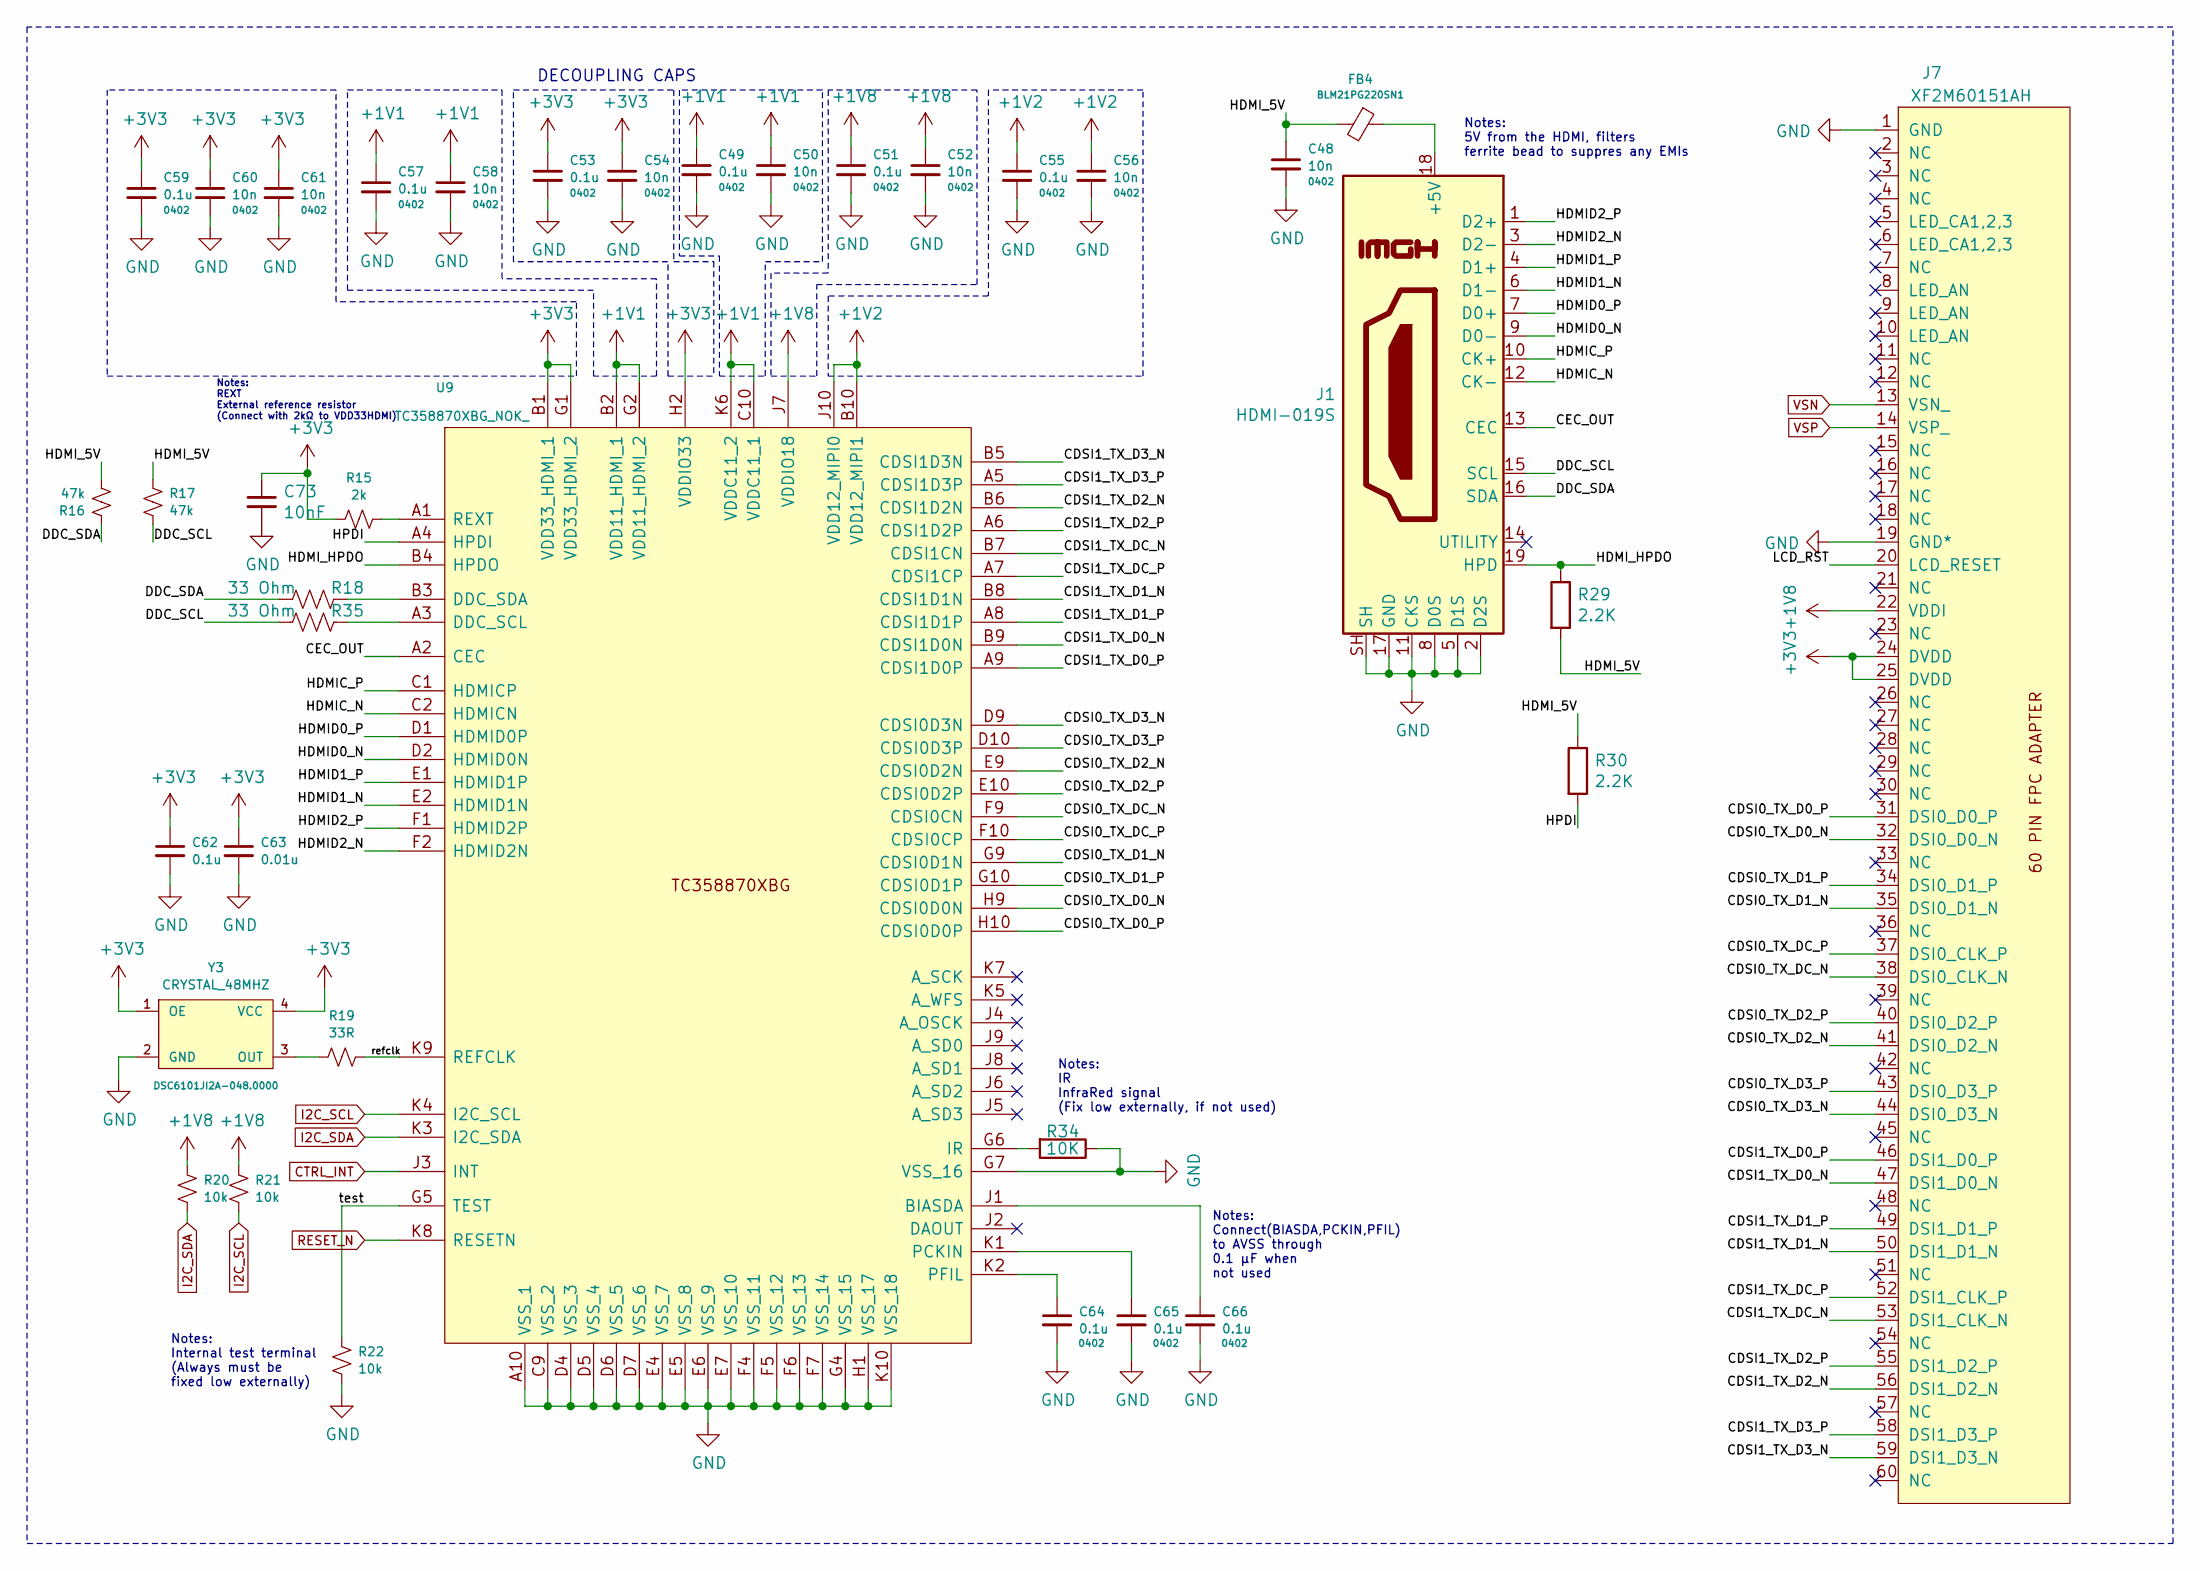
[picture p17: schematic hdmi_mipi_2.sch, HDMI TO MIPI DSI CONVERTER]

Parts:
C48, C50, C52, C54, C56, C58, C60, C61: 10n; C_0402_1005Metric
C49, C51, C53, C55, C57, C59, C62, C64, C65, C66: 0.1u; C_0402_1005Metric
C63: 0.01u; C_0402_1005Metric
C73: 10nF; C_0402_1005Metric
FB4: Ferrite_Bead_Small; L_0603_1608Metric; MPN BLM21PG220SN1
J1: HDMI-019S; MPN HDMI-019S
J7: XF2M60151AH
R15: 2k; R_0402_1005Metric
R16, R17: 47k; R_0402_1005Metric
R18, R35: 33 Ohm; R_0402_1005Metric
R19: 33R; R_0402_1005Metric
R20, R21, R22: 10k; R_0402_1005Metric
R29, R30: 2.2K; R_0402_1005Metric
R34: 10K; R_0402_1005Metric
U9: TC358870XBG_NOK_; VFBGA-80_7x7mm_Pitch0.65mm; MPN TC358870XBG(NOK)
Y3: CRYSTAL_48MHZ; DSC6101JI2A-048.0000; MPN DSC6101JI2A-048.0000

Connections:
+1V1: C49.1, C50.1, C57.1, C58.1, U9.B2 (VDD11_HDMI_1), U9.C10 (VDDC11_1), U9.G2 (VDD11_HDMI_2), U9.K6 (VDDC11_2); also elsewhere on the board
+1V2: C55.1, C56.1, U9.B10 (VDD12_MIPI1), U9.J10 (VDD12_MIPI0); also elsewhere on the board
+1V8: C51.1, C52.1, J7.22 (VDDI), R20.2, R21.2, U9.J7 (VDDIO18); also elsewhere on the board
+3V3: C53.1, C54.1, C59.1, C60.1, C61.1, C62.1, C63.1, C73.1, J7.24 (DVDD), J7.25 (DVDD), R15.2, U9.B1 (VDD33_HDMI_1), U9.G1 (VDD33_HDMI_2), U9.H2 (VDDIO33), Y3.1 (OE), Y3.4 (VCC); also elsewhere on the board
/hdmi_mipi_2/CDSI0_TX_D0_N: J7.32 (DSI0_D0_N), U9.H9 (CDSI0D0N)
/hdmi_mipi_2/CDSI0_TX_D0_P: J7.31 (DSI0_D0_P), U9.H10 (CDSI0D0P)
/hdmi_mipi_2/CDSI0_TX_D1_N: J7.35 (DSI0_D1_N), U9.G9 (CDSI0D1N)
/hdmi_mipi_2/CDSI0_TX_D1_P: J7.34 (DSI0_D1_P), U9.G10 (CDSI0D1P)
/hdmi_mipi_2/CDSI0_TX_D2_N: J7.41 (DSI0_D2_N), U9.E9 (CDSI0D2N)
/hdmi_mipi_2/CDSI0_TX_D2_P: J7.40 (DSI0_D2_P), U9.E10 (CDSI0D2P)
/hdmi_mipi_2/CDSI0_TX_D3_N: J7.44 (DSI0_D3_N), U9.D9 (CDSI0D3N)
/hdmi_mipi_2/CDSI0_TX_D3_P: J7.43 (DSI0_D3_P), U9.D10 (CDSI0D3P)
/hdmi_mipi_2/CDSI0_TX_DC_N: J7.38 (DSI0_CLK_N), U9.F9 (CDSI0CN)
/hdmi_mipi_2/CDSI0_TX_DC_P: J7.37 (DSI0_CLK_P), U9.F10 (CDSI0CP)
/hdmi_mipi_2/CDSI1_TX_D0_N: J7.47 (DSI1_D0_N), U9.B9 (CDSI1D0N)
/hdmi_mipi_2/CDSI1_TX_D0_P: J7.46 (DSI1_D0_P), U9.A9 (CDSI1D0P)
/hdmi_mipi_2/CDSI1_TX_D1_N: J7.50 (DSI1_D1_N), U9.B8 (CDSI1D1N)
/hdmi_mipi_2/CDSI1_TX_D1_P: J7.49 (DSI1_D1_P), U9.A8 (CDSI1D1P)
/hdmi_mipi_2/CDSI1_TX_D2_N: J7.56 (DSI1_D2_N), U9.B6 (CDSI1D2N)
/hdmi_mipi_2/CDSI1_TX_D2_P: J7.55 (DSI1_D2_P), U9.A6 (CDSI1D2P)
/hdmi_mipi_2/CDSI1_TX_D3_N: J7.59 (DSI1_D3_N), U9.B5 (CDSI1D3N)
/hdmi_mipi_2/CDSI1_TX_D3_P: J7.58 (DSI1_D3_P), U9.A5 (CDSI1D3P)
/hdmi_mipi_2/CDSI1_TX_DC_N: J7.53 (DSI1_CLK_N), U9.B7 (CDSI1CN)
/hdmi_mipi_2/CDSI1_TX_DC_P: J7.52 (DSI1_CLK_P), U9.A7 (CDSI1CP)
/hdmi_mipi_2/CEC_OUT: J1.13 (CEC), U9.A2 (CEC)
/hdmi_mipi_2/DDC_SCL: J1.15 (SCL), R17.1, R35.2
/hdmi_mipi_2/DDC_SDA: J1.16 (SDA), R16.2, R18.2
/hdmi_mipi_2/HDMIC_N: J1.12 (CK-), U9.C2 (HDMICN)
/hdmi_mipi_2/HDMIC_P: J1.10 (CK+), U9.C1 (HDMICP)
/hdmi_mipi_2/HDMID0_N: J1.9 (D0-), U9.D2 (HDMID0N)
/hdmi_mipi_2/HDMID0_P: J1.7 (D0+), U9.D1 (HDMID0P)
/hdmi_mipi_2/HDMID1_N: J1.6 (D1-), U9.E2 (HDMID1N)
/hdmi_mipi_2/HDMID1_P: J1.4 (D1+), U9.E1 (HDMID1P)
/hdmi_mipi_2/HDMID2_N: J1.3 (D2-), U9.F2 (HDMID2N)
/hdmi_mipi_2/HDMID2_P: J1.1 (D2+), U9.F1 (HDMID2P)
/hdmi_mipi_2/HDMI_5V: C48.1, FB4.2, R16.1, R17.2, R29.2, R30.1
/hdmi_mipi_2/HDMI_HPDO: J1.19 (HPD), R29.1, U9.B4 (HPDO)
/hdmi_mipi_2/HPDI: R30.2, U9.A4 (HPDI)
/hdmi_mipi_2/refclk: R19.1, U9.K9 (REFCLK)
/hdmi_mipi_2/test: R22.2, U9.G5 (TEST)
CTRL_INT: U9.J3 (INT); also elsewhere on the board
GND: C48.2, C49.2, C50.2, C51.2, C52.2, C53.2, C54.2, C55.2, C56.2, C57.2, C58.2, C59.2, C60.2, C61.2, C62.2, C63.2, C64.2, C65.2, C66.2, C73.2, J1.2 (D2S), J1.5 (D1S), J1.8 (D0S), J1.11 (CKS), J1.17 (GND), J1.SH, J7.1 (GND), J7.19 (GND*), R22.1, R34.1, U9.A10 (VSS_1), U9.C9 (VSS_2), U9.D4 (VSS_3), U9.D5 (VSS_4), U9.D6 (VSS_5), U9.D7 (VSS_6), U9.E4 (VSS_7), U9.E5 (VSS_8), U9.E6 (VSS_9), U9.E7 (VSS_10), U9.F4 (VSS_11), U9.F5 (VSS_12), U9.F6 (VSS_13), U9.F7 (VSS_14), U9.G4 (VSS_15), U9.G7 (VSS_16), U9.H1 (VSS_17), U9.K10 (VSS_18), Y3.2 (GND); also elsewhere on the board
I2C_SCL: R21.1, U9.K4 (I2C_SCL); also elsewhere on the board
I2C_SDA: R20.1, U9.K3 (I2C_SDA); also elsewhere on the board
unnamed: C64.1, U9.K2 (PFIL)
unnamed: C65.1, U9.K1 (PCKIN)
unnamed: C66.1, U9.J1 (BIASDA)
unnamed: FB4.1, J1.18 (+5V)
unnamed: R15.1, U9.A1 (REXT)
unnamed: R18.1, U9.B3 (DDC_SDA)
unnamed: R19.2, Y3.3 (OUT)
unnamed: R34.2, U9.G6 (IR)
unnamed: R35.1, U9.A3 (DDC_SCL)
RESET_N: U9.K8 (RESETN); also elsewhere on the board
VSN: J7.13 (VSN_); also elsewhere on the board
VSP: J7.14 (VSP_); also elsewhere on the board

Notes on the sheet:
DECOUPLING CAPS
Notes: Internal test terminal (Always must be fixed low externally)
Notes: IR InfraRed signal (Fix low externally, if not used)
Notes: Connect(BIASDA,PCKIN,PFIL) to AVSS through 0.1 μF when not used
Notes: REXT External reference resistor (Connect with 2kΩ to VDD33HDMI)
Notes: 5V from the HDMI, filters ferrite bead to suppres any EMIs

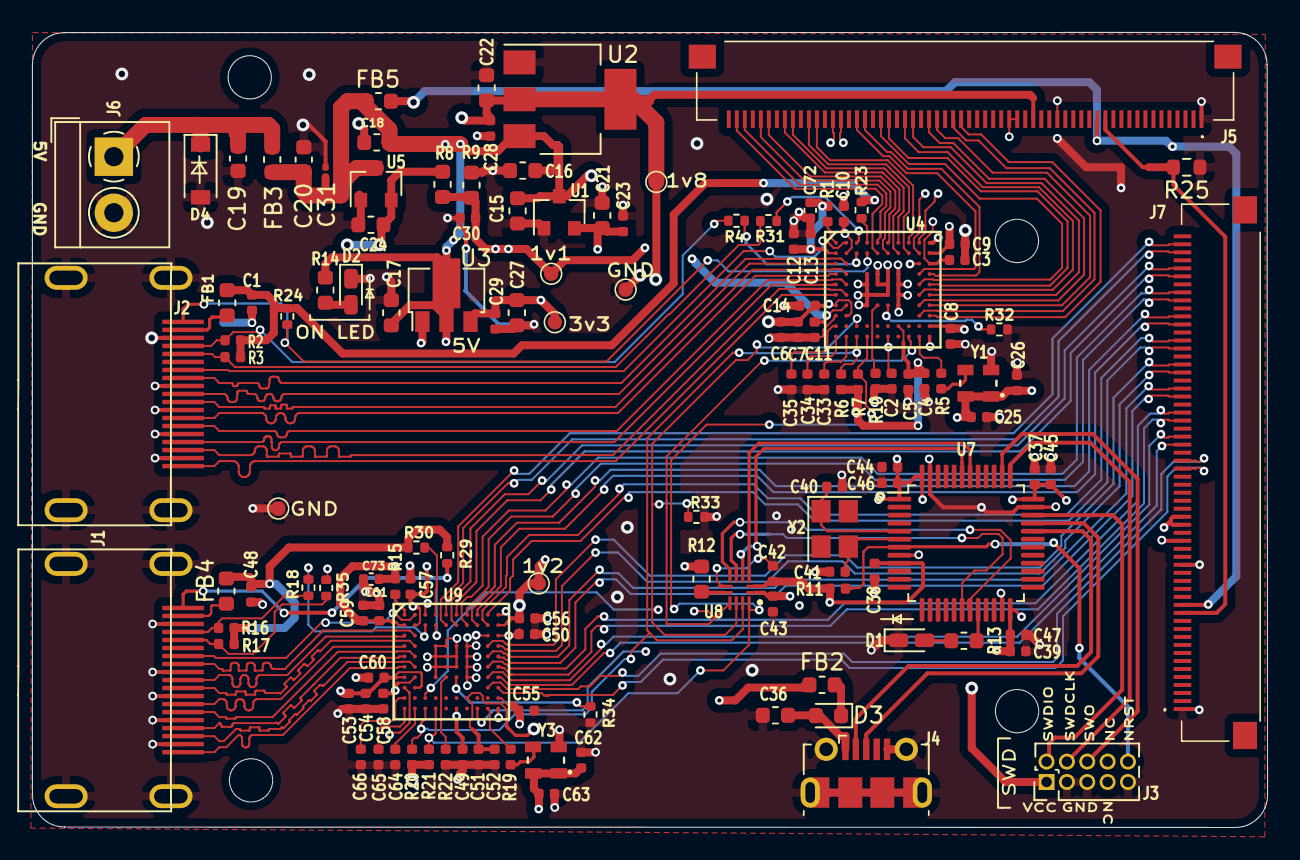
[picture p18: board hdmi_to_mipi-dsi_converter.kicad_pcb from above]

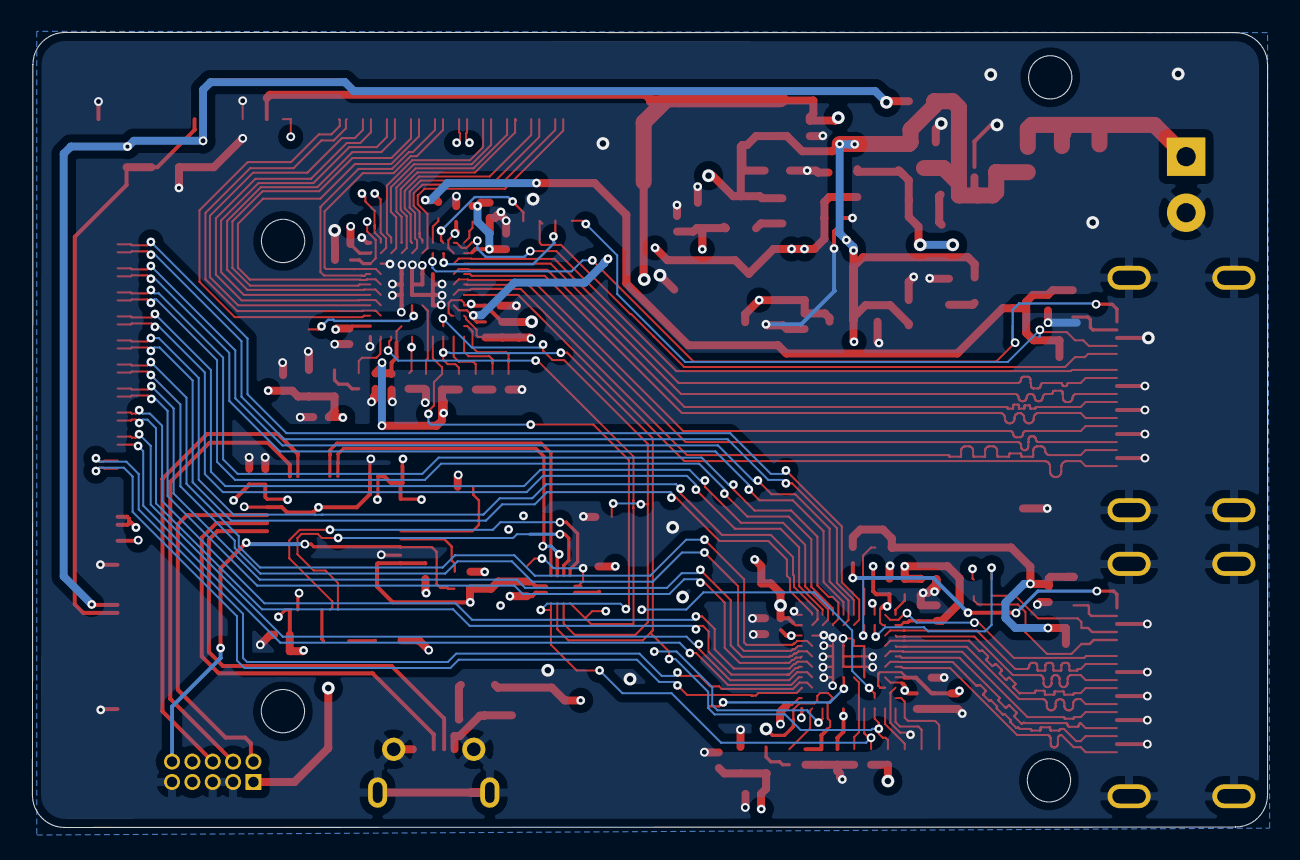
[picture p19: board hdmi_to_mipi-dsi_converter.kicad_pcb from below]

Board: 4 copper layers, 77.1 x 49.6 mm, 136 parts (4 on the bottom side), 122 nets.
