R-Mutura/HDMI-TO-MIPI-MAIN/(commit log)

2021-11-18 new commits>>layout complete and proper...BOM awaiting
    [WBBOMDesignTPS54332DDAR.csv, hdmi_mipi_2.sch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]
2021-11-19 updated all files and production files as well
    [hdmi_mipi_2.sch, hdmi_to_mipi-dsi_converter version 2.xlsx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]
2021-12-01 reduced form factor
    [hdmi_to_mipi-dsi_converter version 2.xlsx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]
2021-12-23 update on HDMI to MIPI
    [hdmi_to_mipi-dsi_converter version 2.xlsx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]
2021-12-23 update on the hdmi to mipi
    [hdmi_to_mipi-dsi_converter-B_Cu.gbr, hdmi_to_mipi-dsi_converter-B_Mask.gbr, hdmi_to_mipi-dsi_converter-B_Paste.gbr, hdmi_to_mipi-dsi_converter-B_SilkS.gbr, hdmi_to_mipi-dsi_converter-Edge_Cuts.gbr, hdmi_to_mipi-dsi_converter-F_Cu.gbr, hdmi_to_mipi-dsi_converter-F_Mask.gbr, hdmi_to_mipi-dsi_converter-F_Paste.gbr]
